simoninns/Acorn-Master-AIV/(threads)

Thread 1 (2019-06-06):

Sheet 17 - RTC IC identification number incorrect

simoninns, 2019-06-06:
The original Master 128 schematic only says 146818 and the chip datasheet for the MC146818P states that 1 and 16 are NC. So I'd conclude that both the new schematic and the original are incorrect, as the chip has to be a 'P' since the 'A' datasheet shows 1 and 16 to have a function.

i.e. the schematic should be marked MC146818P not MC146818A

kgl2001, 2019-06-06:
The MC146818 and MC146818P are one of the same thing. The P suffix just defines the Plastic package case.

The MC146818A on the other hand is something subtly different. It is an upgraded version of the MC146818 which utilises pins 1 & 16 for other functions. The MC146818A also comes in various packages, including P and this is sometimes referred to as MC146818AP.

I believe your final conclusion is correct. The schematic should be marked either MC146818 or MC146818P. It should not be MC146818A.

simoninns, 2019-06-06:
Fixed in latest commit

Closed 2019-06-06.

Thread 3 (2020-04-16):

16MHz Clock routing error

kgl2001, 2020-04-16:
As per post on Stardot:

https://stardot.org.uk/forums/viewtopic.php?f=3&t=16827&p=265560#p265560

In the schematic you have 16MHz clock from IC43 pin 2 wired directly to IC40 pin 9 & IC42 pin 8 and indirectly to IC35 pin 2 via the jumper LK60.

According to the circuit diagram on MDFS, the 16MHz clock from IC43 pin 2 should be wired direct to IC40 pin 9, and indirectly to IC42 pin 8 & IC35 pin 2 via the jumper LK60.

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
