simoninns/Acorn-Master-AIV/Schematics/Acorn 65C102 Second Processor/PDF/Acorn 65C102 Second Processor.pdf

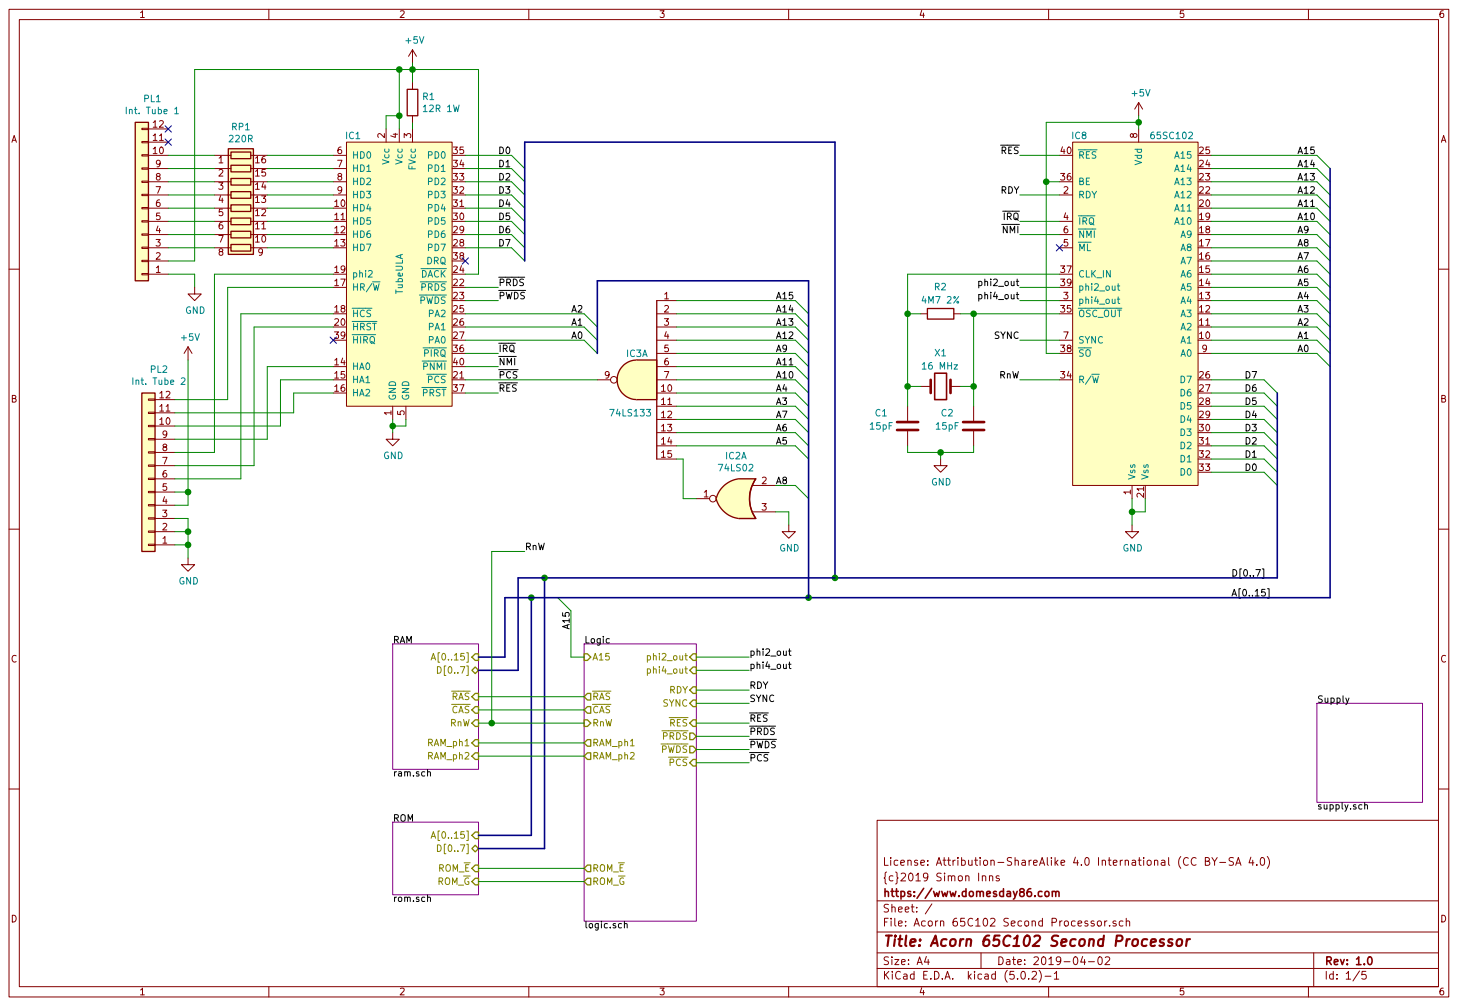
[picture p1: page 1]

+5V GND 1 1223456789 PL2 10

{c}2019 Simon Inns
Id: 1/5 Title: Acorn 65C102 Second Processor File: Acorn 65C102 Second Processor.sch Sheet: / https://www.domesday86.com

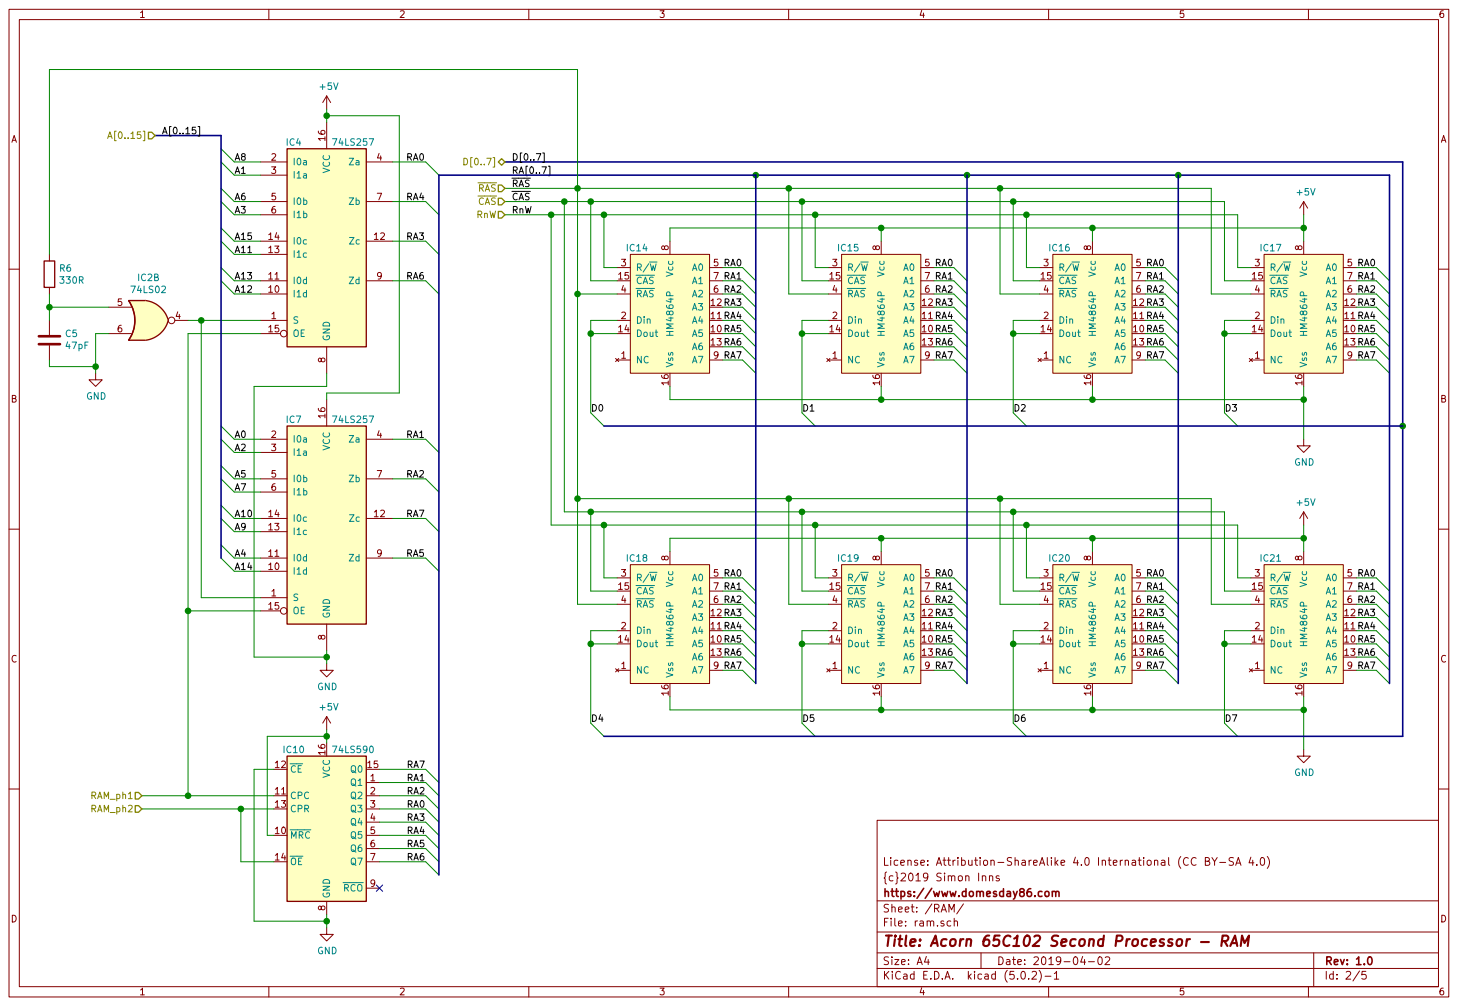
[picture p2: page 2]

RA[0..7] RAS CAS RnW S 1

License: Attribution-ShareAlike 4.0 International (CC BY-SA 4.0)
{c}2019 Simon Inns
File: ram.sch Sheet: /RAM/ https://www.domesday86.com

Id: 2/5 Title: Acorn 65C102 Second Processor - RAM

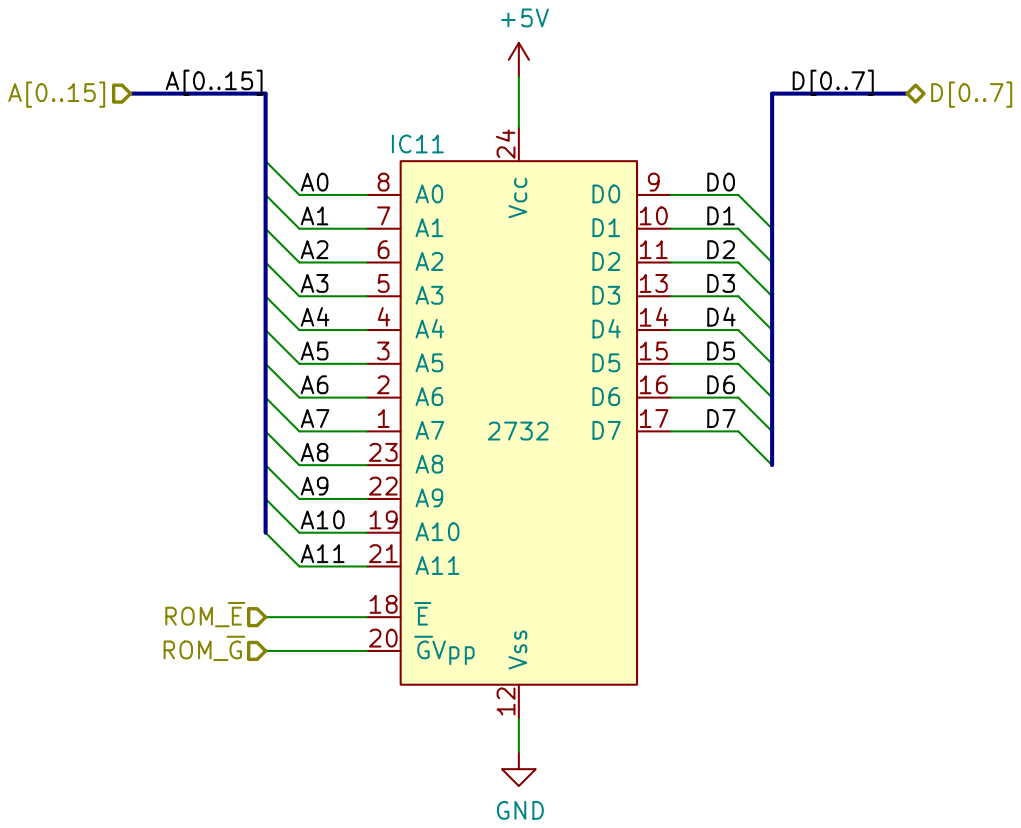
[picture p3: page 3]

{c}2019 Simon Inns
File: rom.sch Sheet: /ROM/ https://www.domesday86.com

Id: 3/5 Title: Acorn 65C102 Second Processor - ROM

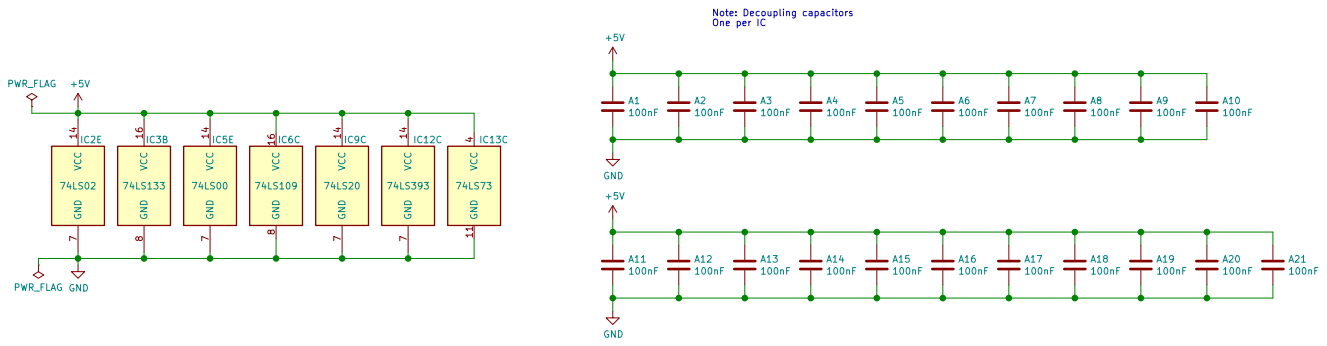
[picture p4: page 4]

License: Attribution-ShareAlike 4.0 International (CC BY-SA 4.0) VCC 14 GND

{c}2019 Simon Inns
https://www.domesday86.com
Sheet: /Supply/
File: supply.sch
Id: 4/5 Title: Acorn 65C102 Second Processor - Supply

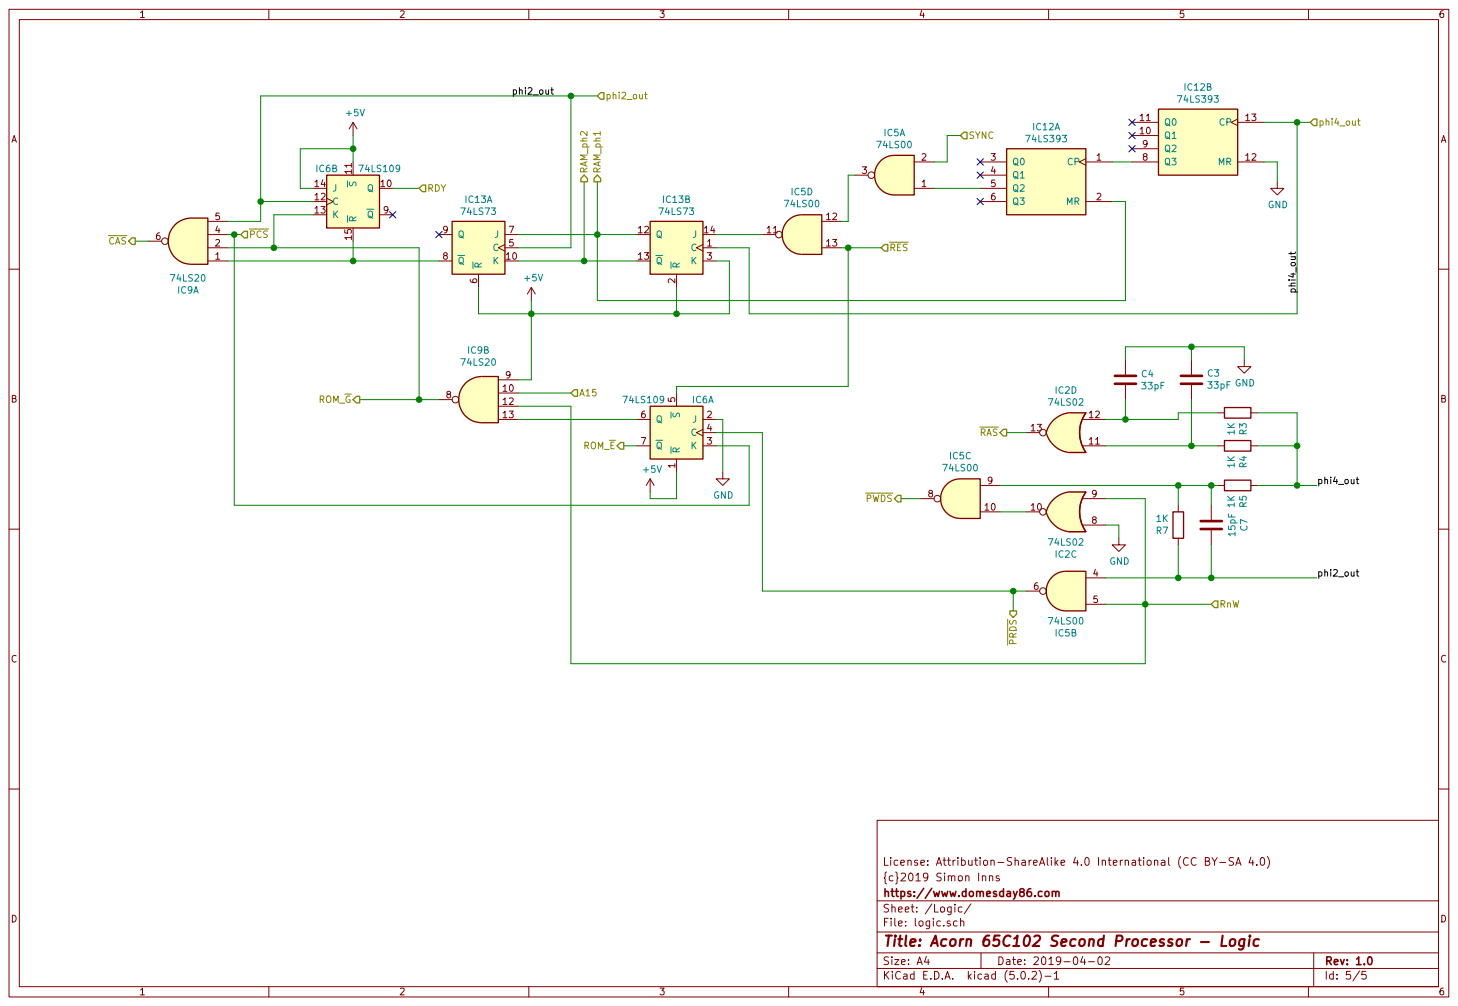
[picture p5: page 5]

License: Attribution-ShareAlike 4.0 International (CC BY-SA 4.0)
{c}2019 Simon Inns
https://www.domesday86.com
Sheet: /Logic/
File: logic.sch
Id: 5/5 Title: Acorn 65C102 Second Processor - Logic
