simoninns/Acorn-Master-AIV/Schematics/Acorn Master 128/Acorn Master 128/PDF/Acorn Master 128.pdf

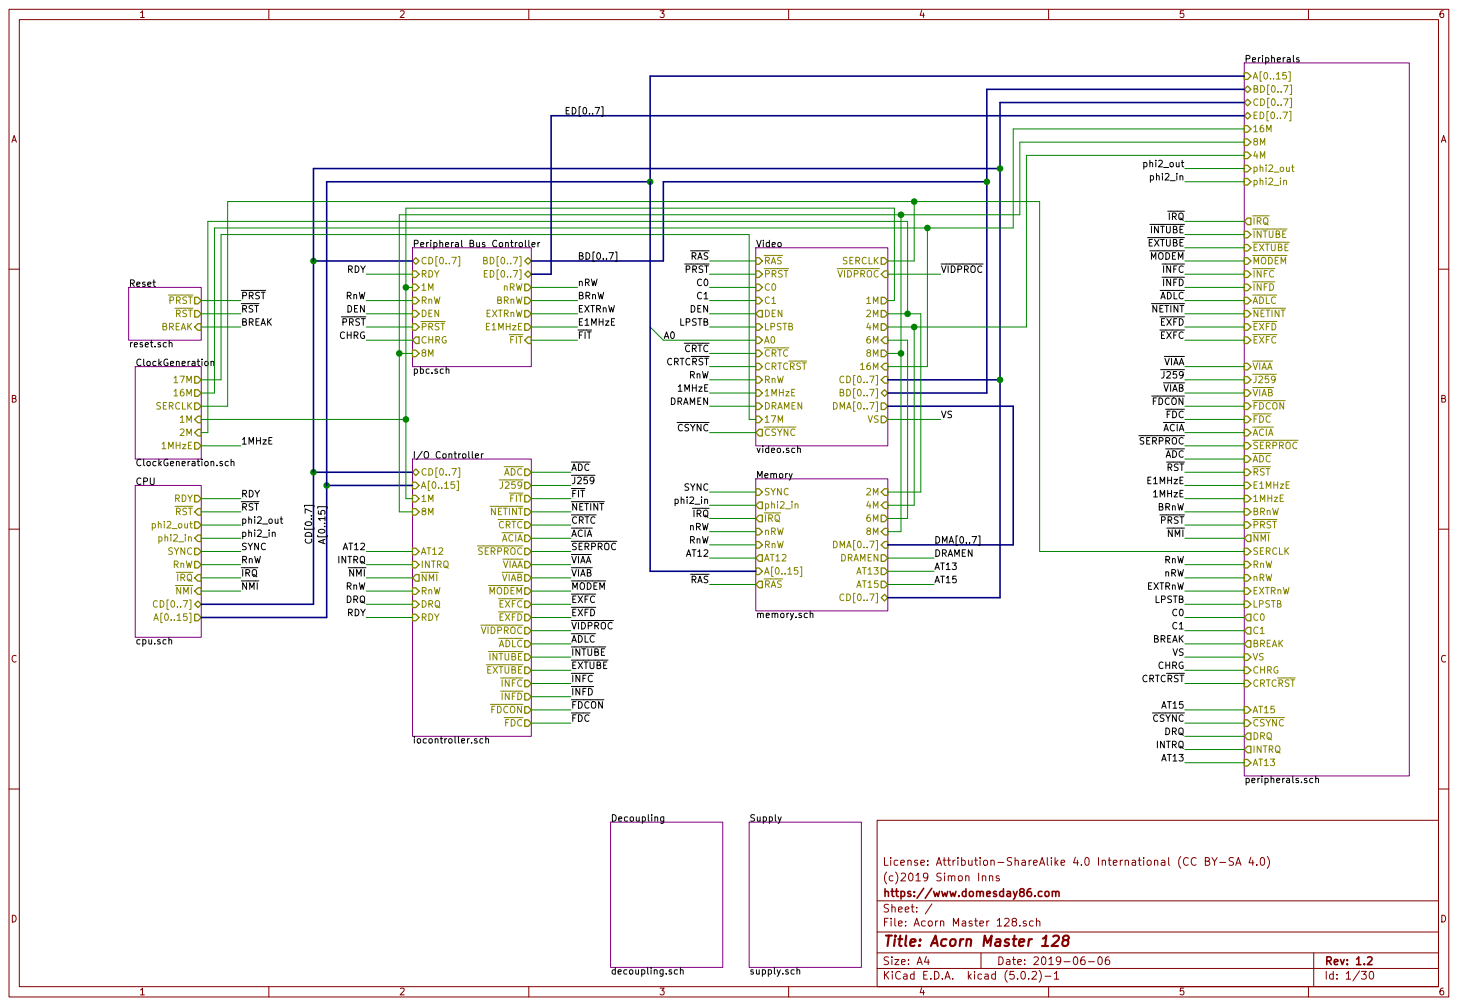
[picture p6: page 1]

A0 Reset reset.sch PRST RST BREAK

BD[0..7] ClockGeneration ClockGeneration.sch SERCLK

License: Attribution-ShareAlike 4.0 International (CC BY-SA 4.0) CPU

(c)2019 Simon Inns
File: Acorn Master 128.sch Sheet: / https://www.domesday86.com

Id: 1/30 Title: Acorn Master 128

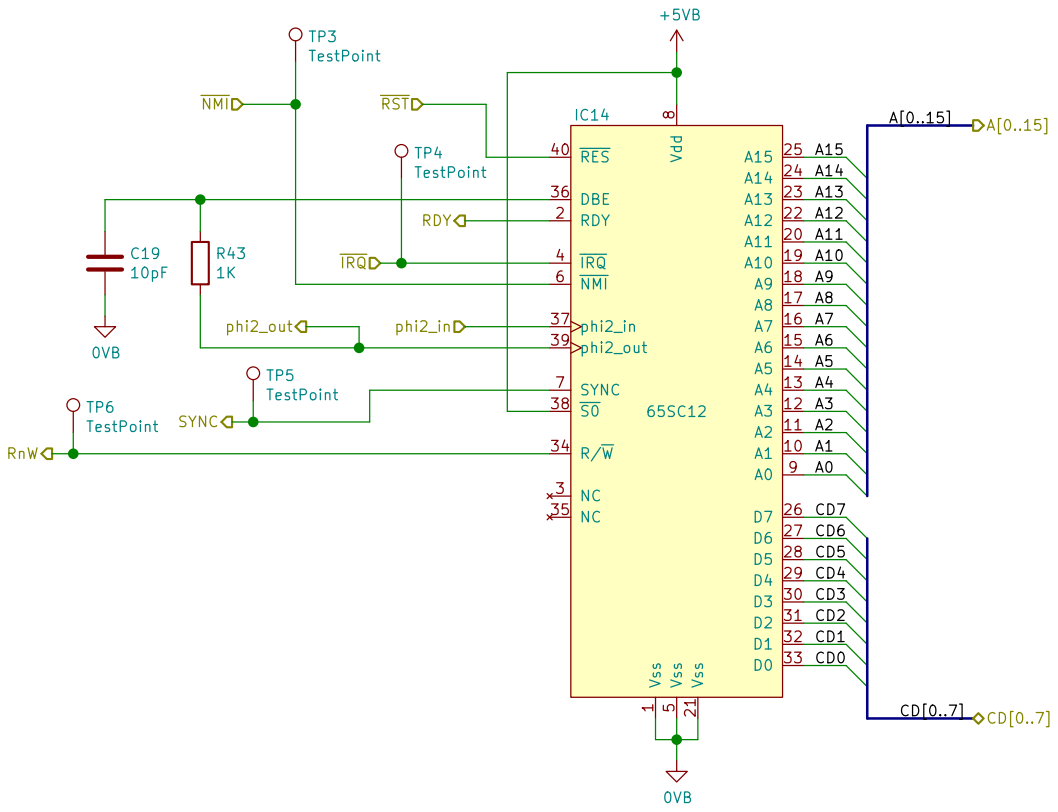
[picture p7: page 2]

(c)2019 Simon Inns
File: cpu.sch Sheet: /CPU/ https://www.domesday86.com

Id: 2/30 Title: Acorn Master 128 - CPU

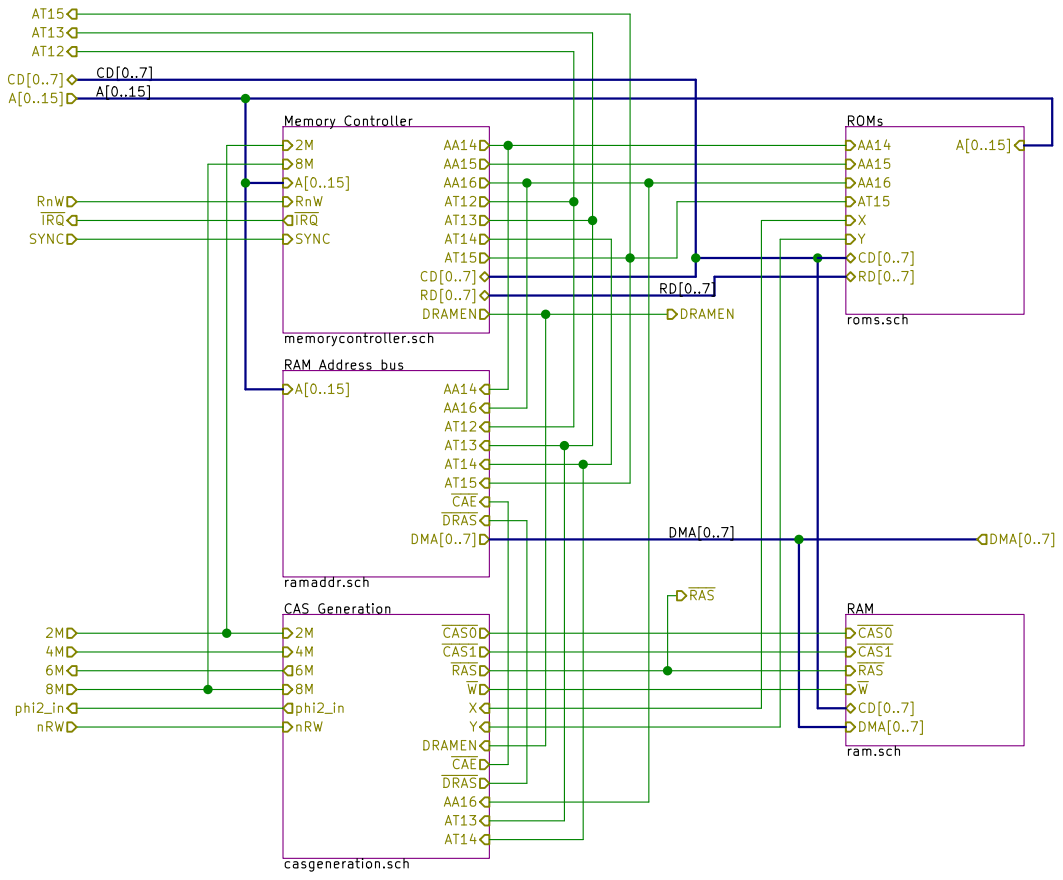
[picture p8: page 3]

memorycontroller.sch
DMA[0..7] RAM Address bus

ram.sch CAS0 RAS CAS1 CD[0..7] W

License: Attribution-ShareAlike 4.0 International (CC BY-SA 4.0)
(c)2019 Simon Inns
https://www.domesday86.com
Sheet: /Memory/
File: memory.sch
Id: 3/30 Title: Acorn Master 128 - Memory

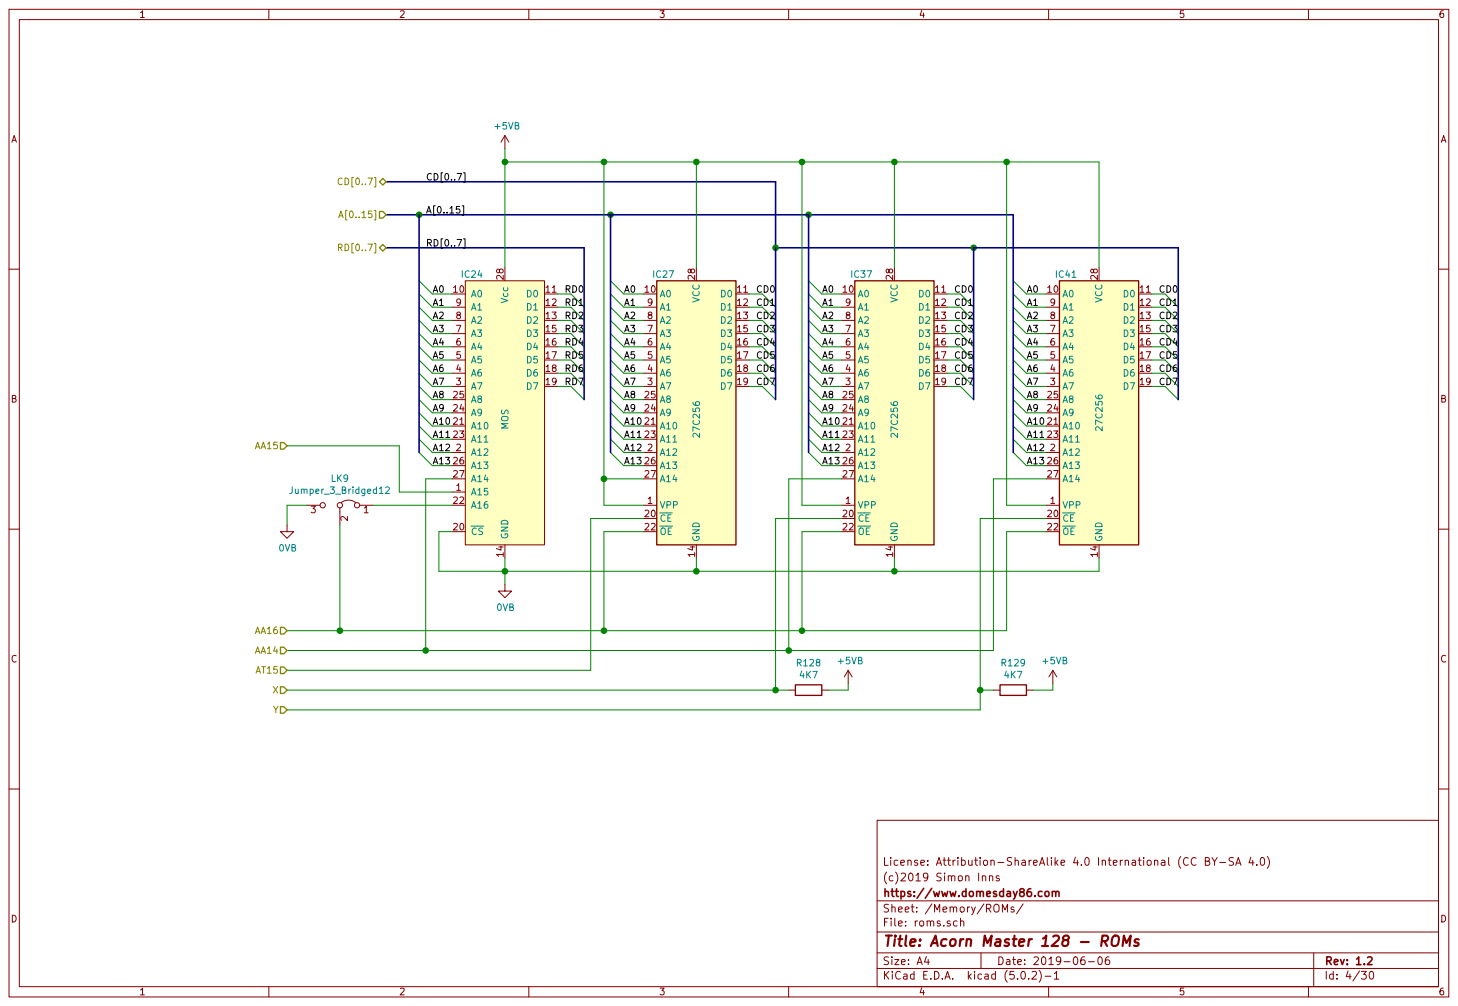
[picture p9: page 4]

(c)2019 Simon Inns
https://www.domesday86.com
File: roms.sch Sheet: /Memory/ROMs/
Id: 4/30 Title: Acorn Master 128 - ROMs

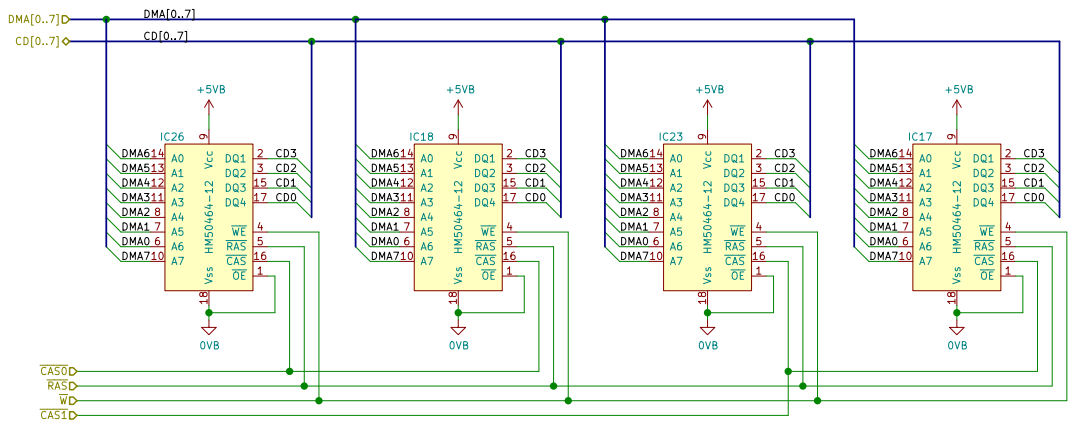
[picture p10: page 5]

(c)2019 Simon Inns
https://www.domesday86.com
File: ram.sch Sheet: /Memory/RAM/
Id: 5/30 Title: Acorn Master 128 - RAM

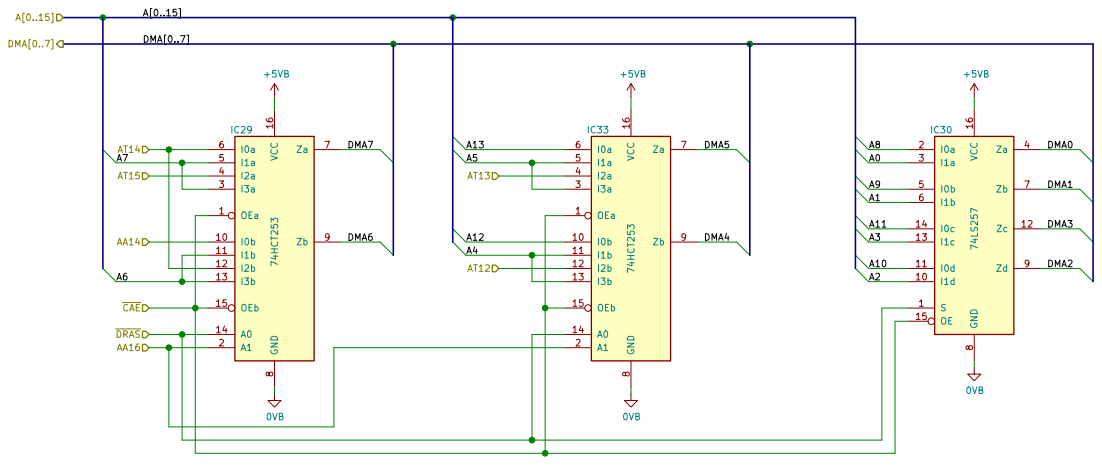
[picture p11: page 6]

License: Attribution-ShareAlike 4.0 International (CC BY-SA 4.0) OEa 1

I1b 11
I2b 12

(c)2019 Simon Inns
https://www.domesday86.com
File: ramaddr.sch Sheet: /Memory/RAM Address bus/
Id: 6/30 Title: Acorn Master 128 - RAM Address Bus

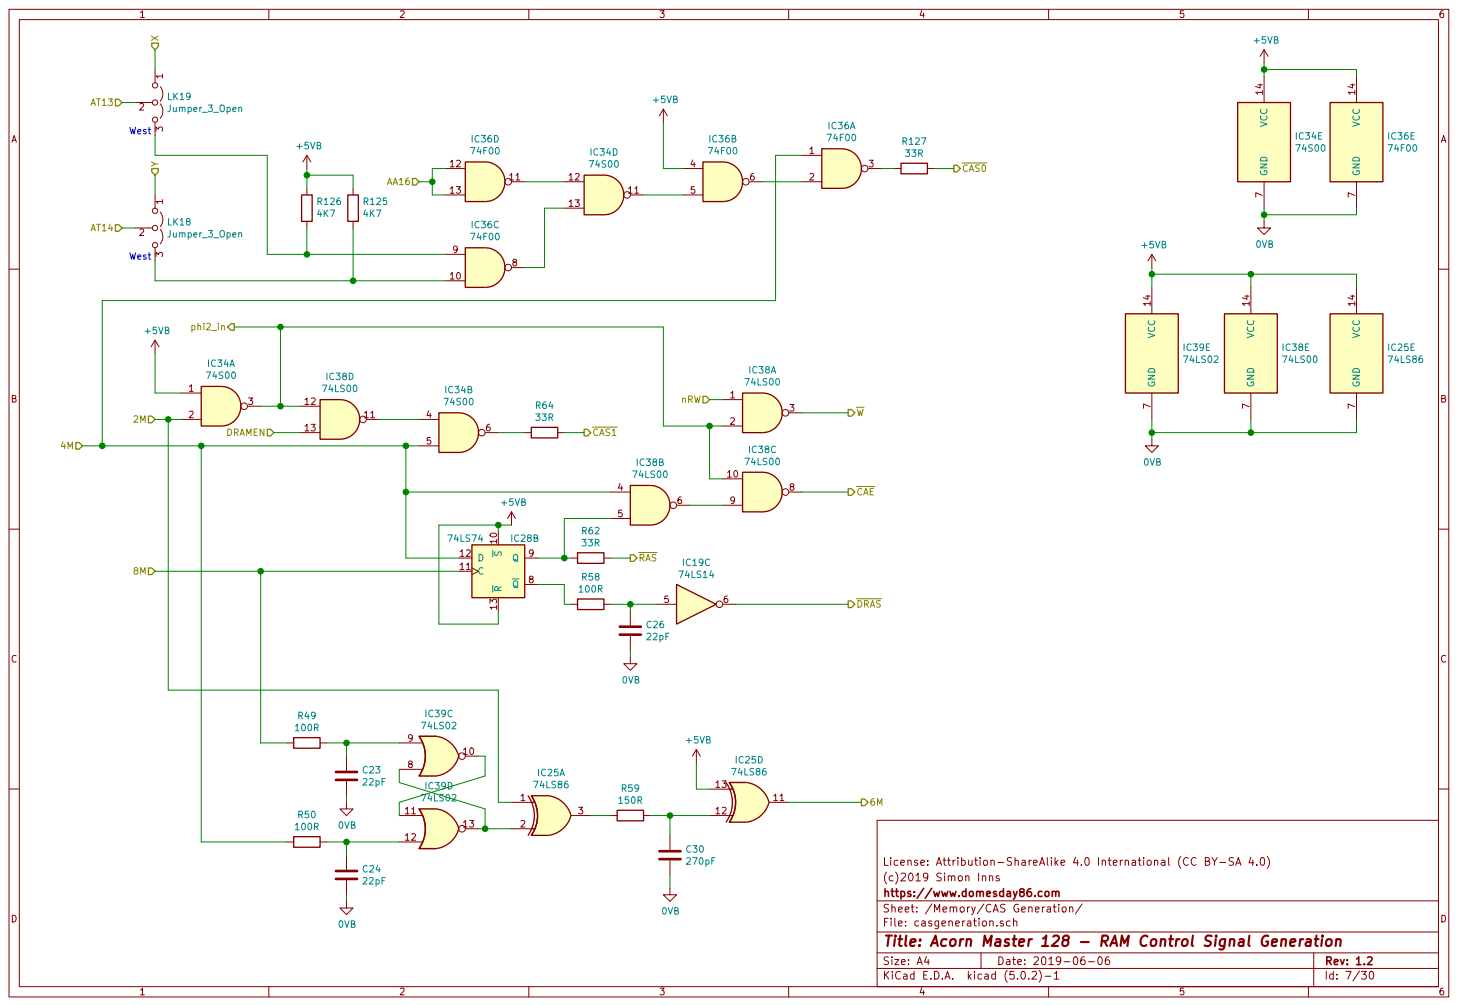
[picture p12: page 7]

License: Attribution-ShareAlike 4.0 International (CC BY-SA 4.0)
(c)2019 Simon Inns
https://www.domesday86.com
Sheet: /Memory/CAS Generation/
File: casgeneration.sch
Id: 7/30 Title: Acorn Master 128 - RAM Control Signal Generation

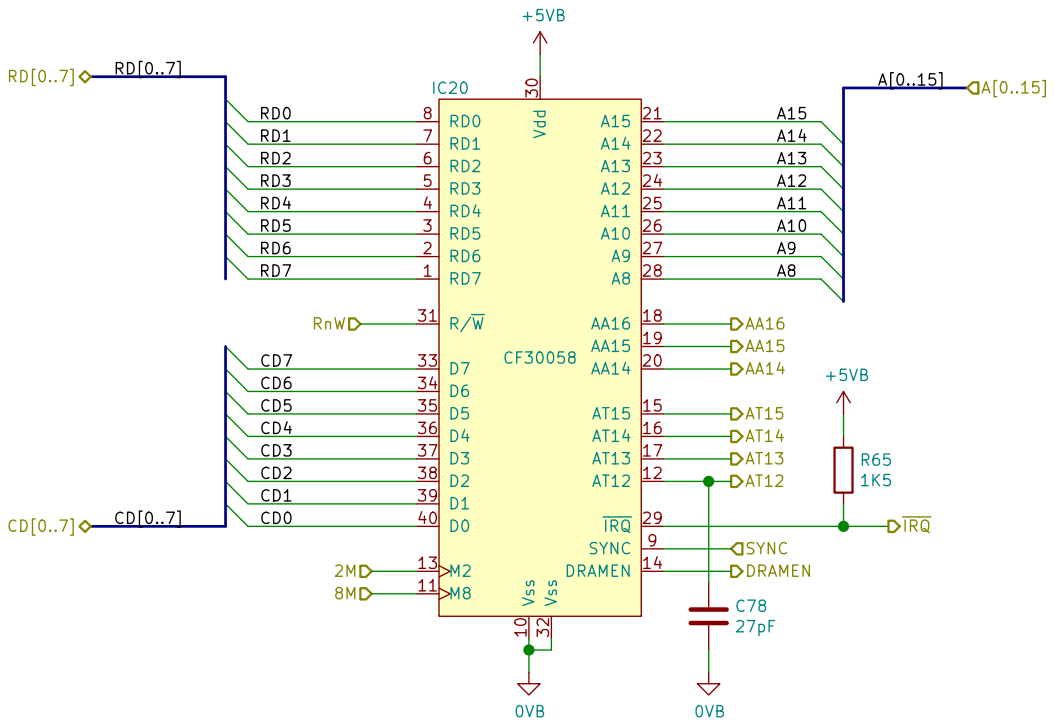
[picture p13: page 8]

(c)2019 Simon Inns
https://www.domesday86.com
Sheet: /Memory/Memory Controller/
File: memorycontroller.sch
Id: 8/30 Title: Acorn Master 128 - Memory Controller

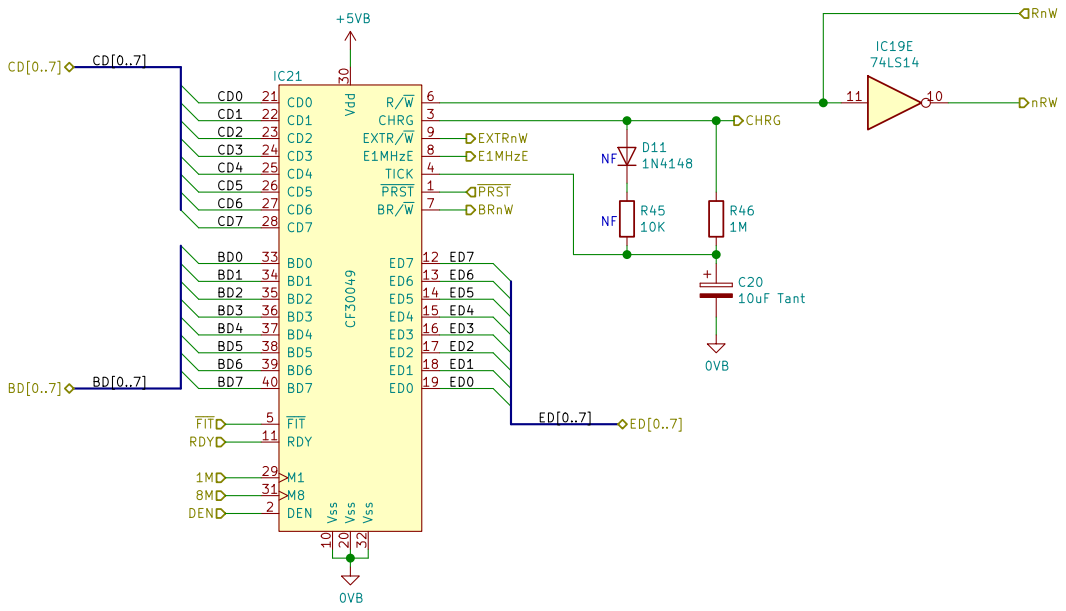
[picture p14: page 9]

License: Attribution-ShareAlike 4.0 International (CC BY-SA 4.0)
(c)2019 Simon Inns
https://www.domesday86.com
Sheet: /Peripheral Bus Controller/
File: pbc.sch
Id: 9/30 Title: Acorn Master 128 - Peripheral Bus Controller

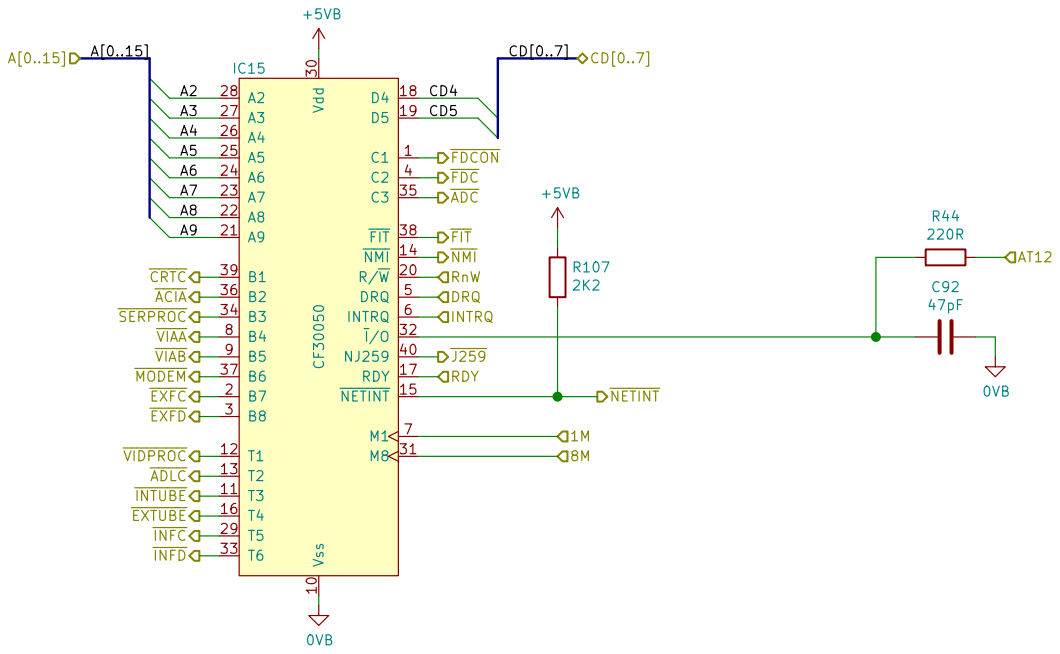
[picture p15: page 10]

License: Attribution-ShareAlike 4.0 International (CC BY-SA 4.0)
(c)2019 Simon Inns
Id: 10/30 Title: Acorn Master 128 - I/O Controller File: iocontroller.sch Sheet: /I/O Controller/ https://www.domesday86.com

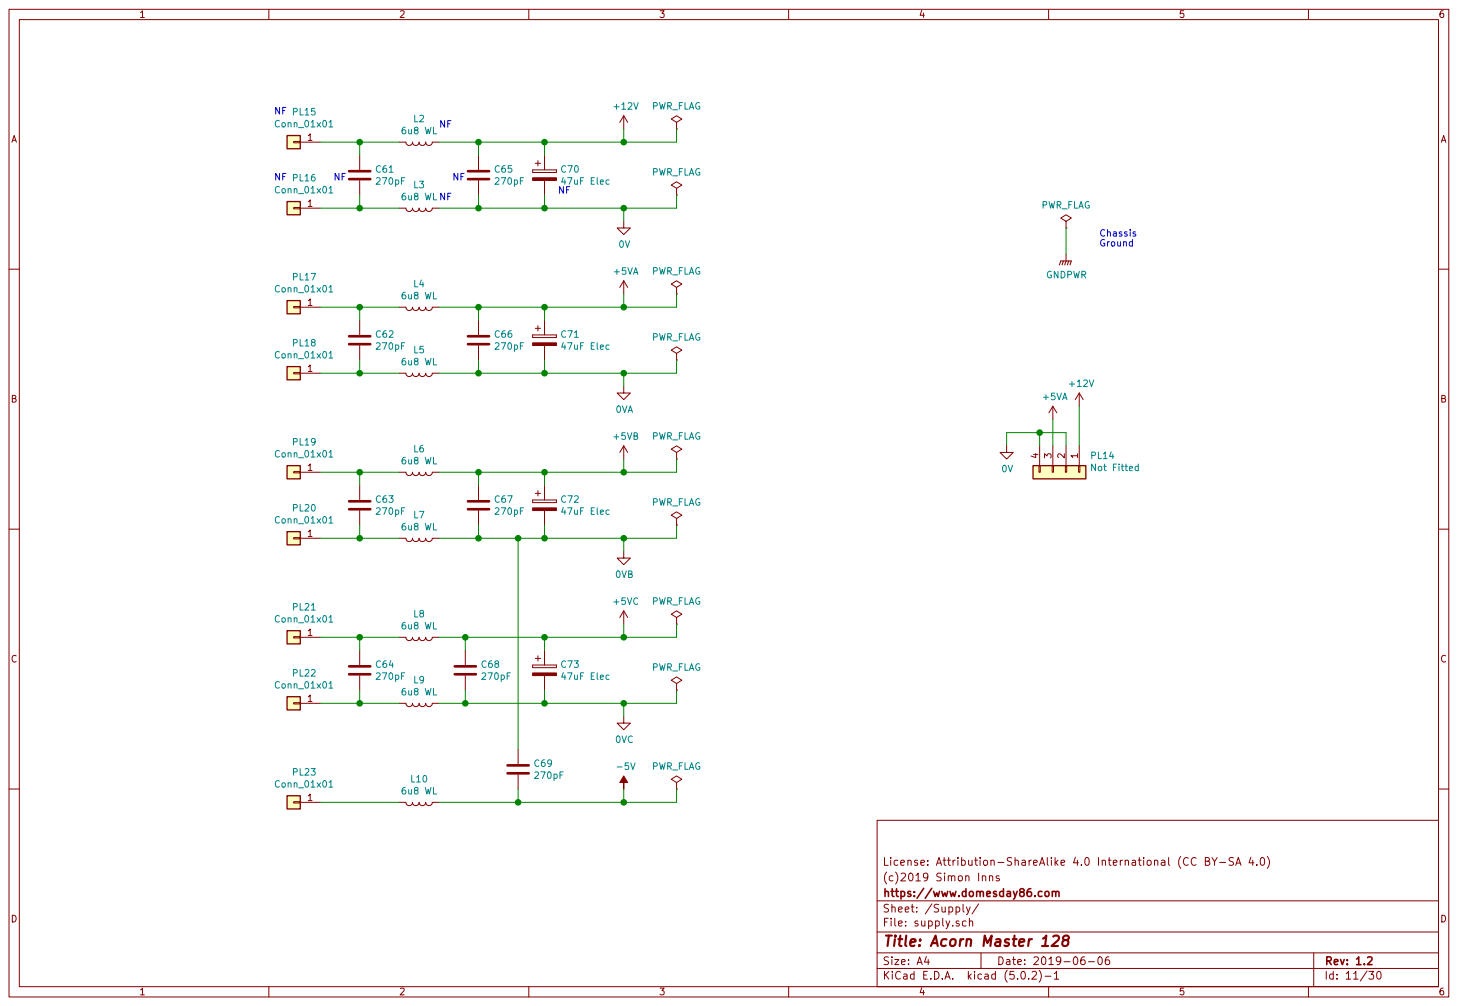
[picture p16: page 11]

License: Attribution-ShareAlike 4.0 International (CC BY-SA 4.0) 1 PL15 Conn_01x01 1 PL16 Conn_01x01 1 PL17 Conn_01x01 1 PL18 Conn_01x01 1 PL19 Conn_01x01 1 PL20 Conn_01x01 1 PL21 Conn_01x01 1 PL22 Conn_01x01 1 PL23 Conn_01x01

(c)2019 Simon Inns
https://www.domesday86.com
Sheet: /Supply/
File: supply.sch
Id: 11/30 Title: Acorn Master 128

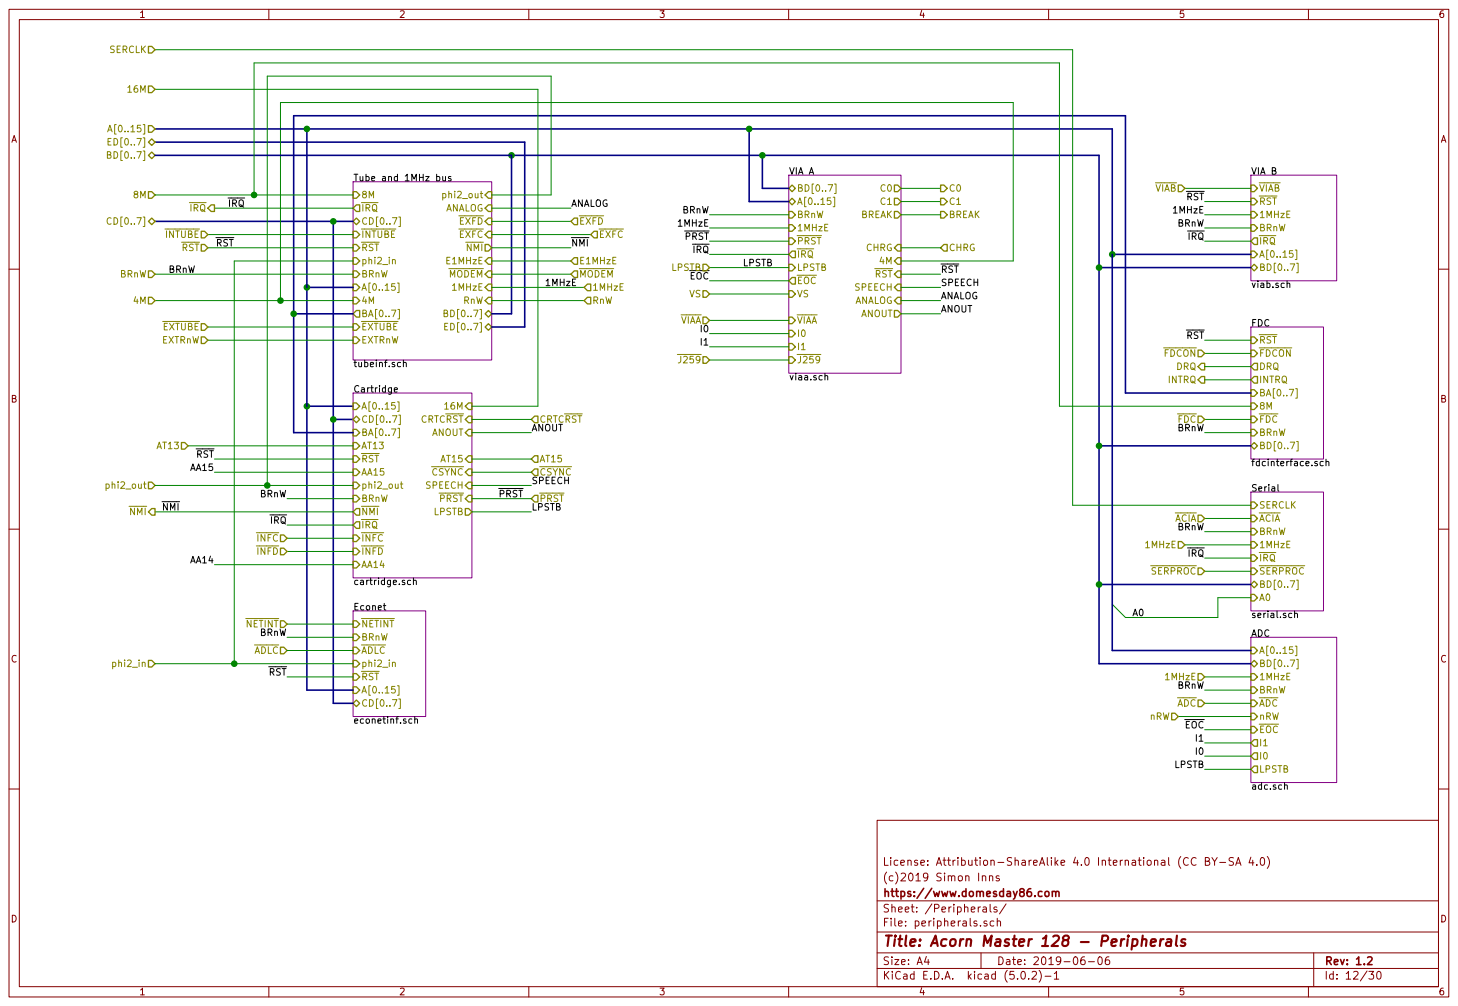
[picture p17: page 12]

VIA B
viab.sch VIAB RST

FDC
BRnW
Serial serial.sch SERCLK

License: Attribution-ShareAlike 4.0 International (CC BY-SA 4.0) Econet econetinf.sch NETINT BRnW

(c)2019 Simon Inns
https://www.domesday86.com
Sheet: /Peripherals/
File: peripherals.sch
Id: 12/30 Title: Acorn Master 128 - Peripherals

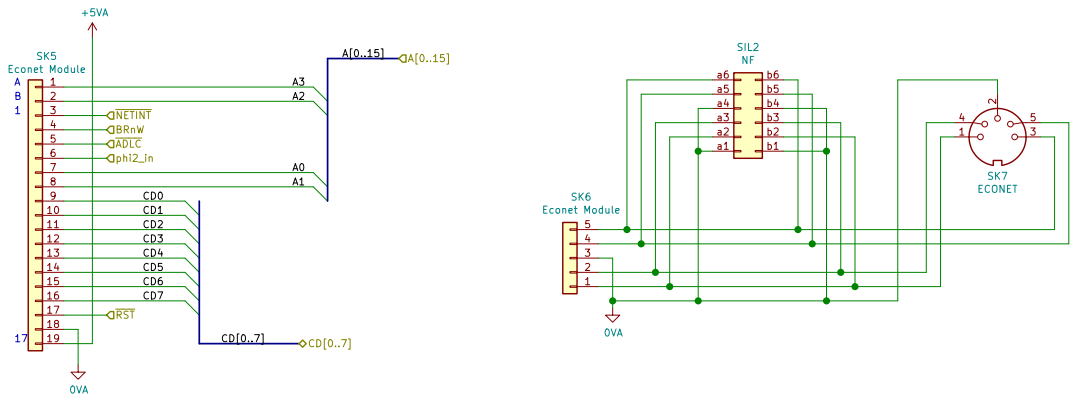
[picture p18: page 13]

a4 | | b4
a3 | | b3
a2 | | b2
a1 | | b1

License: Attribution-ShareAlike 4.0 International (CC BY-SA 4.0)
(c)2019 Simon Inns
https://www.domesday86.com
Id: 13/30 Title: Acorn Master 128 - Econet File: econetinf.sch Sheet: /Peripherals/Econet/

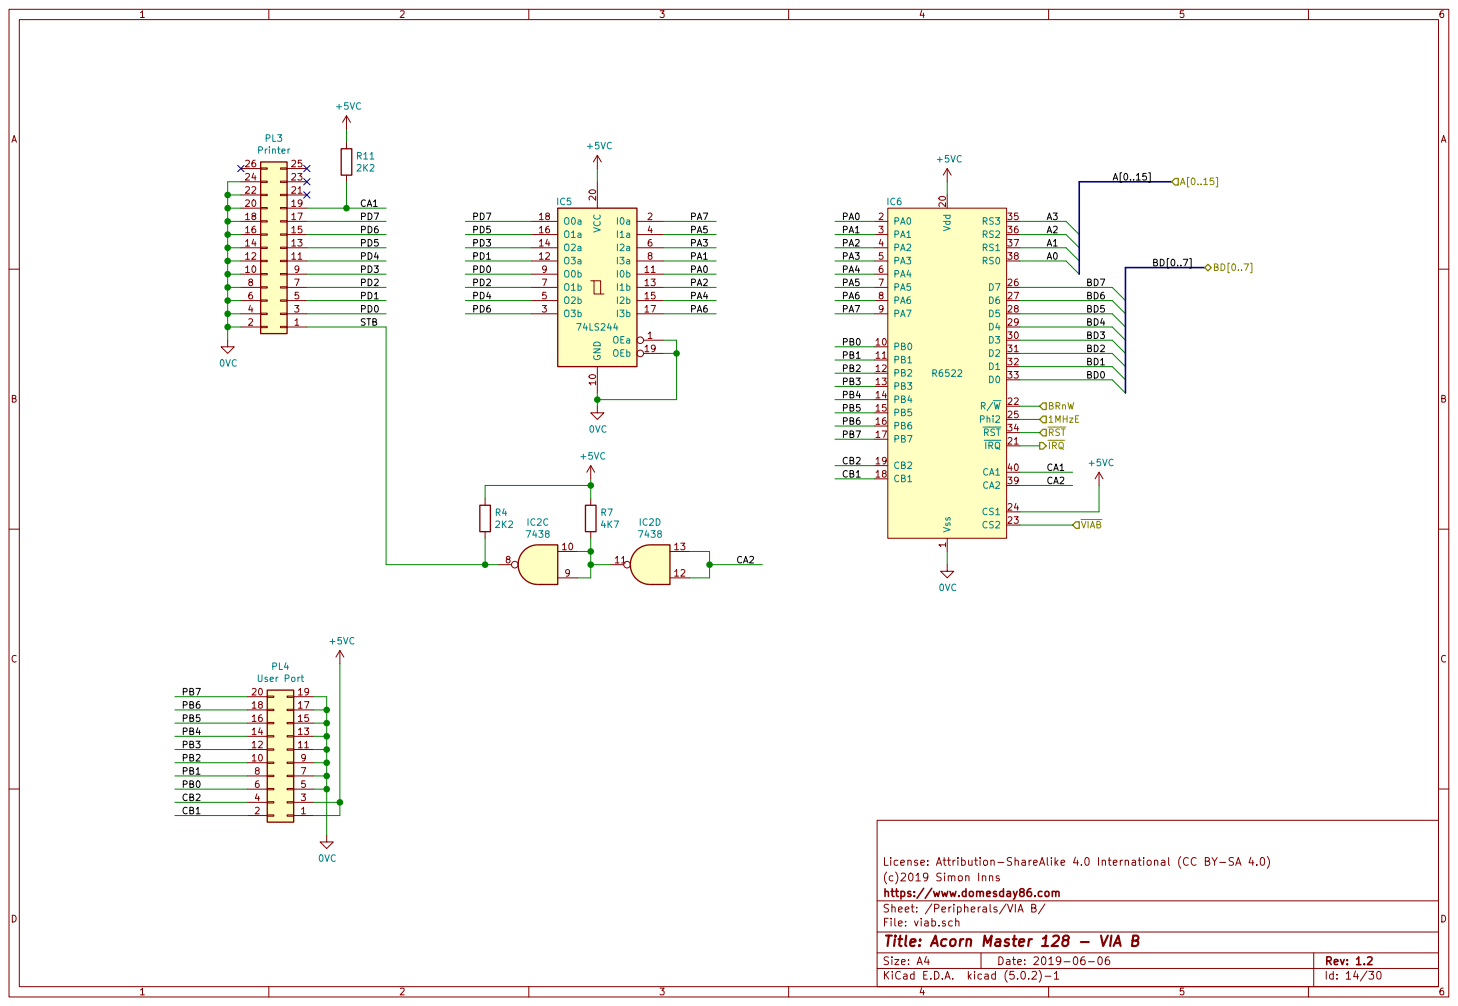
[picture p19: page 14]

16 | 15
14 | 13
12 | 11

License: Attribution-ShareAlike 4.0 International (CC BY-SA 4.0) 1

(c)2019 Simon Inns
https://www.domesday86.com
File: viab.sch Sheet: /Peripherals/VIA B/
Id: 14/30 Title: Acorn Master 128 - VIA B

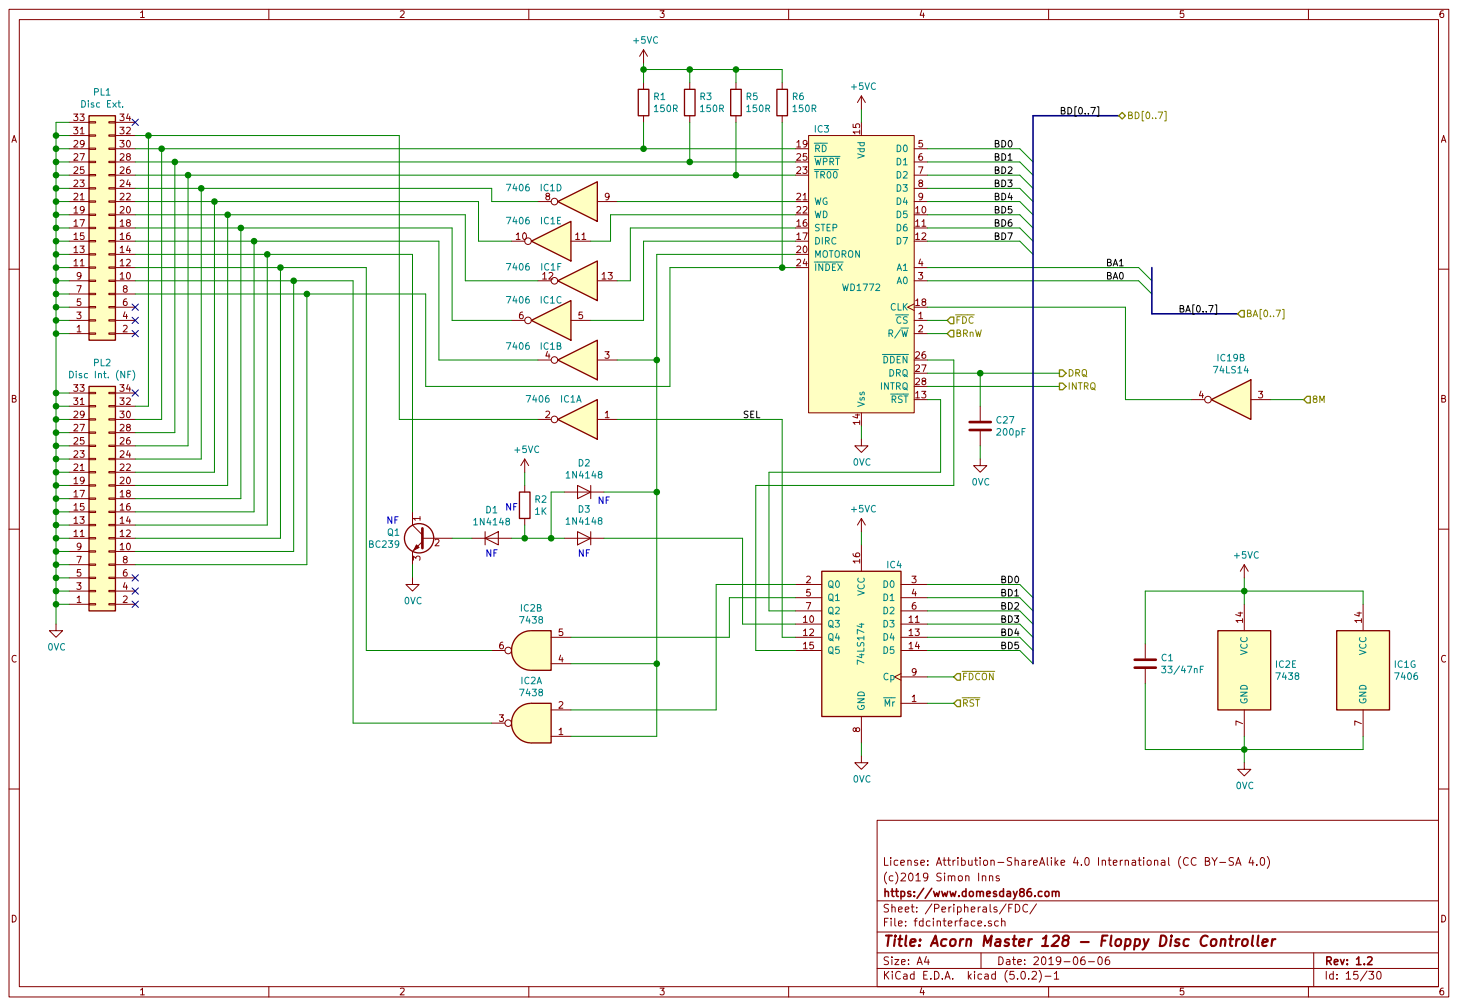
[picture p20: page 15]

293 21 | 22
27 | 28
25 | 26
23 | 24

15 | 16
13 | 14
11 | 12

License: Attribution-ShareAlike 4.0 International (CC BY-SA 4.0)
(c)2019 Simon Inns
https://www.domesday86.com
Id: 15/30 Title: Acorn Master 128 - Floppy Disc Controller File: fdcinterface.sch Sheet: /Peripherals/FDC/

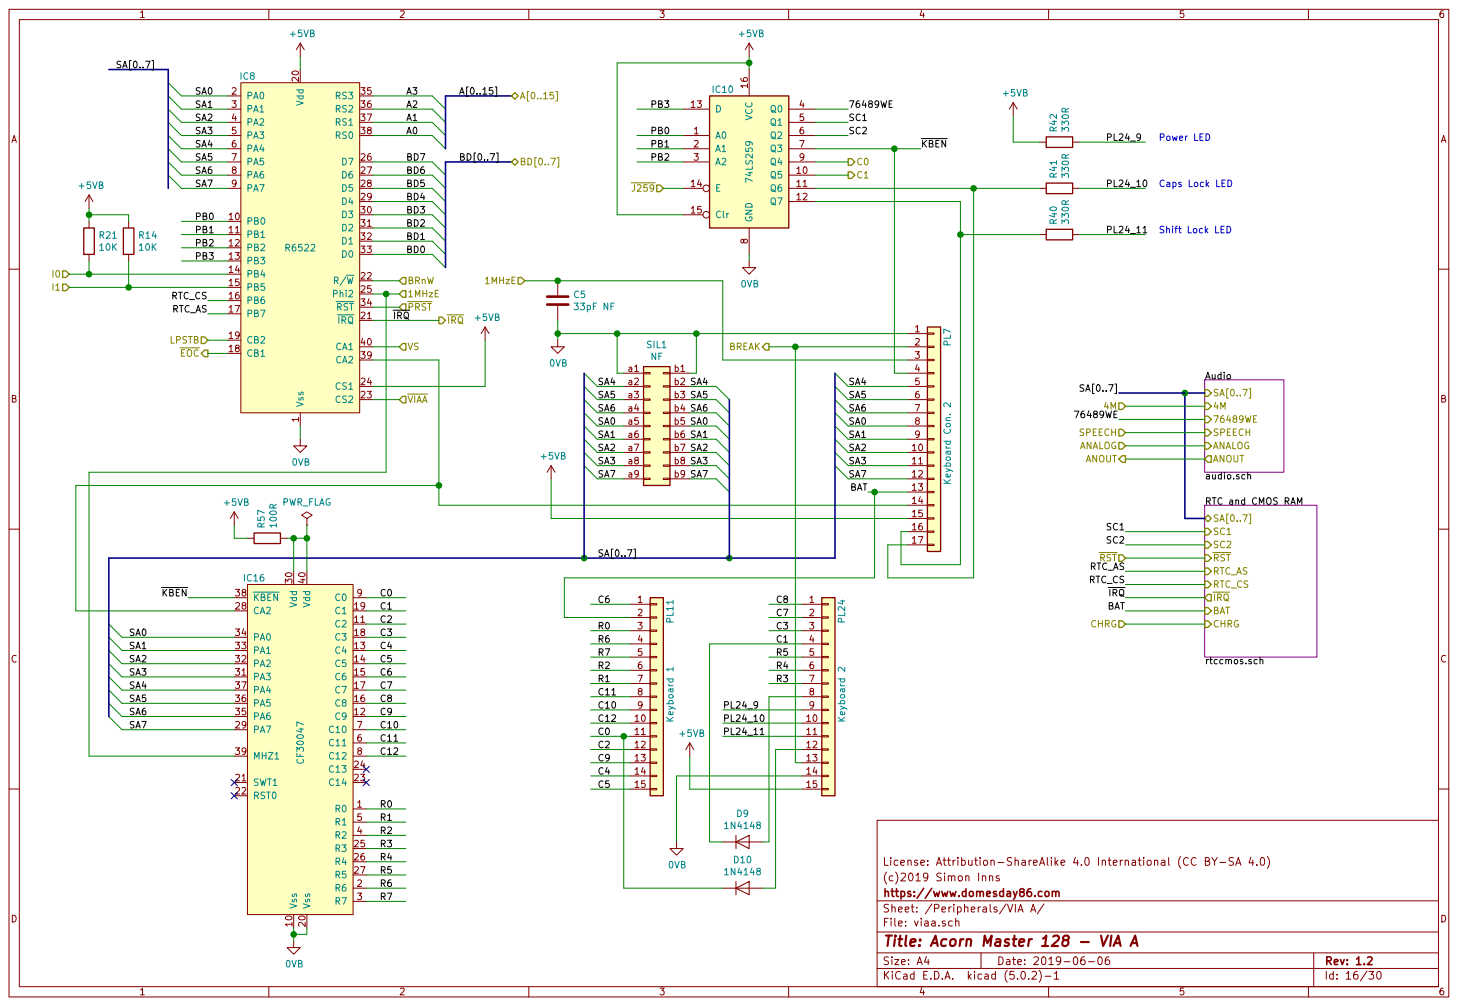
[picture p21: page 16]

10
11
12

(c)2019 Simon Inns
https://www.domesday86.com
File: viaa.sch Sheet: /Peripherals/VIA A/
Id: 16/30 Title: Acorn Master 128 - VIA A

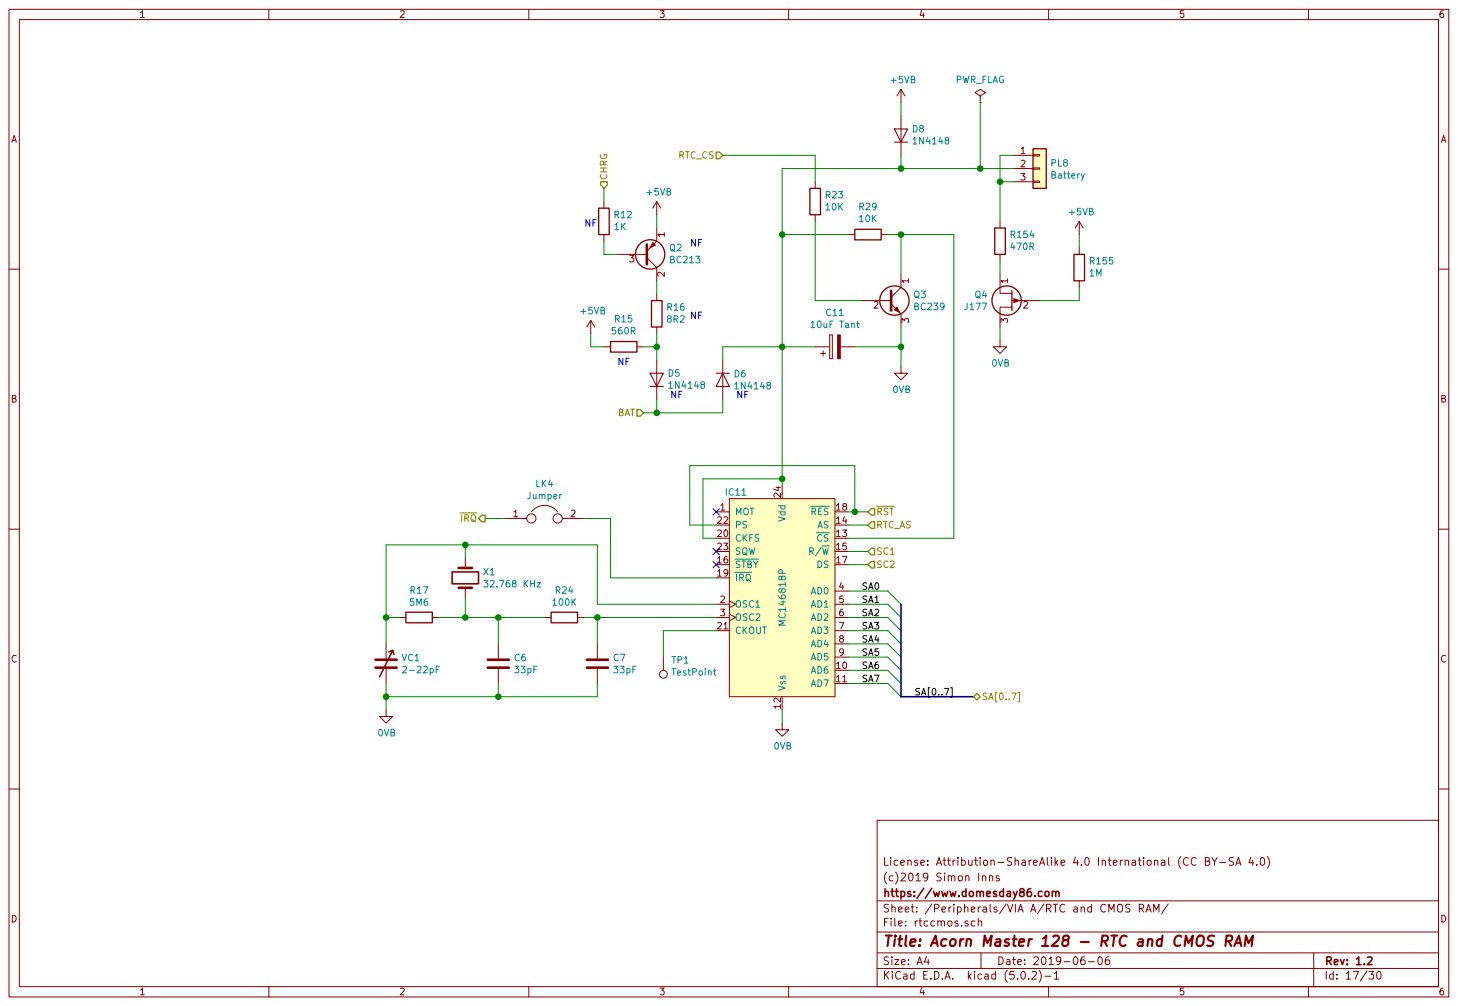
[picture p22: page 17]

(c)2019 Simon Inns
https://www.domesday86.com
File: rtccmos.sch Sheet: /Peripherals/VIA A/RTC and CMOS RAM/
Id: 17/30 Title: Acorn Master 128 - RTC and CMOS RAM

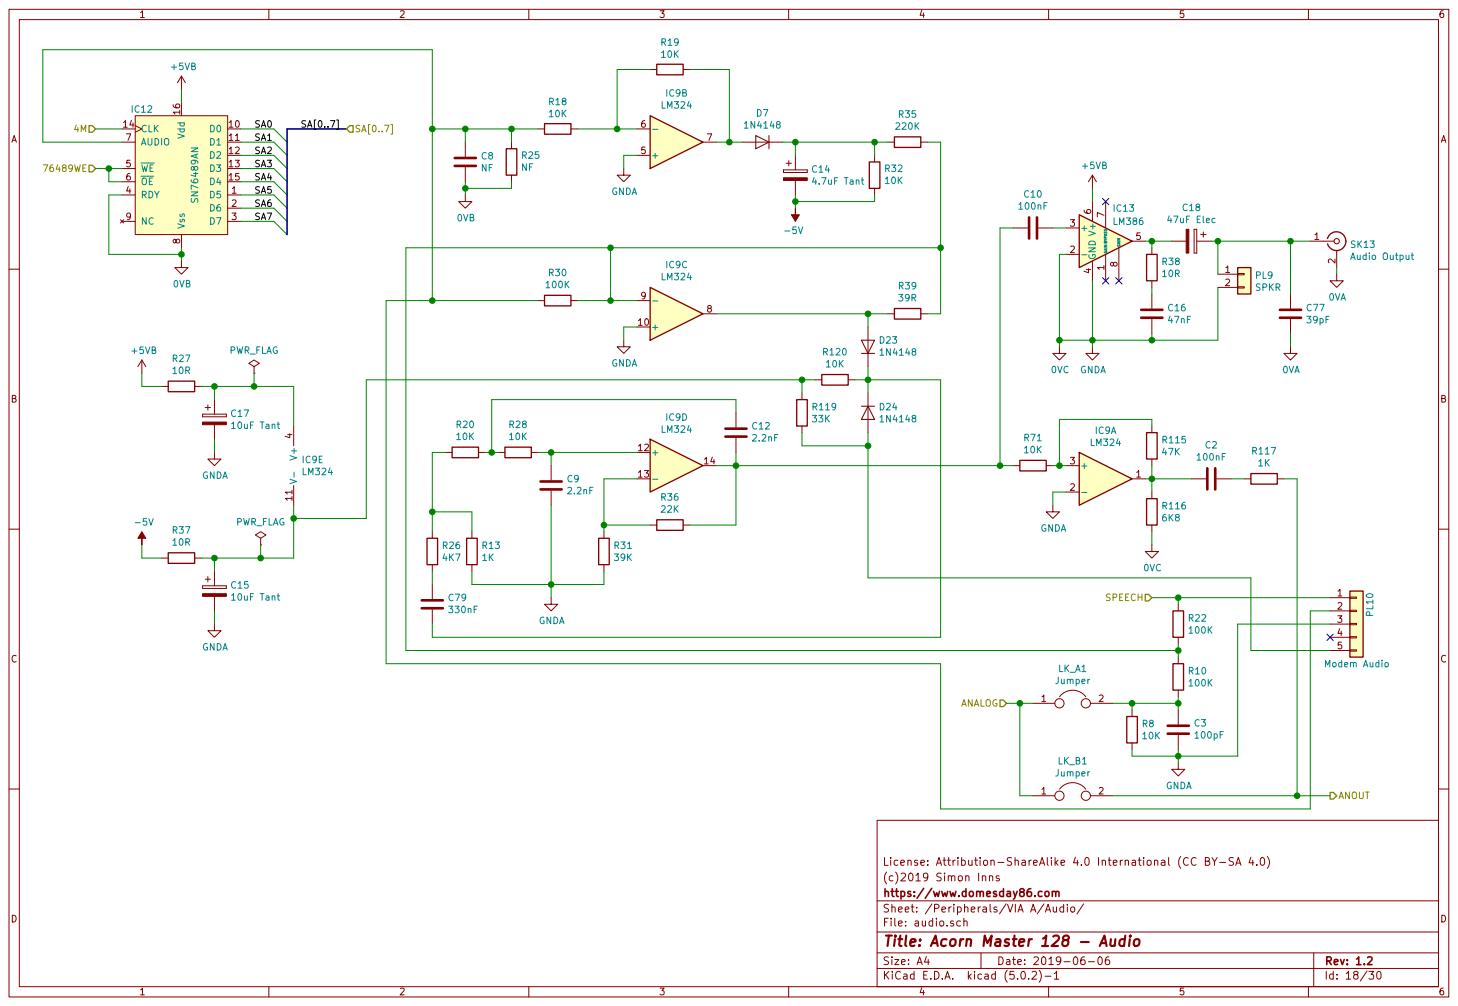
[picture p23: page 18]

License: Attribution-ShareAlike 4.0 International (CC BY-SA 4.0)
(c)2019 Simon Inns
https://www.domesday86.com
File: audio.sch Sheet: /Peripherals/VIA A/Audio/
Id: 18/30 Title: Acorn Master 128 - Audio

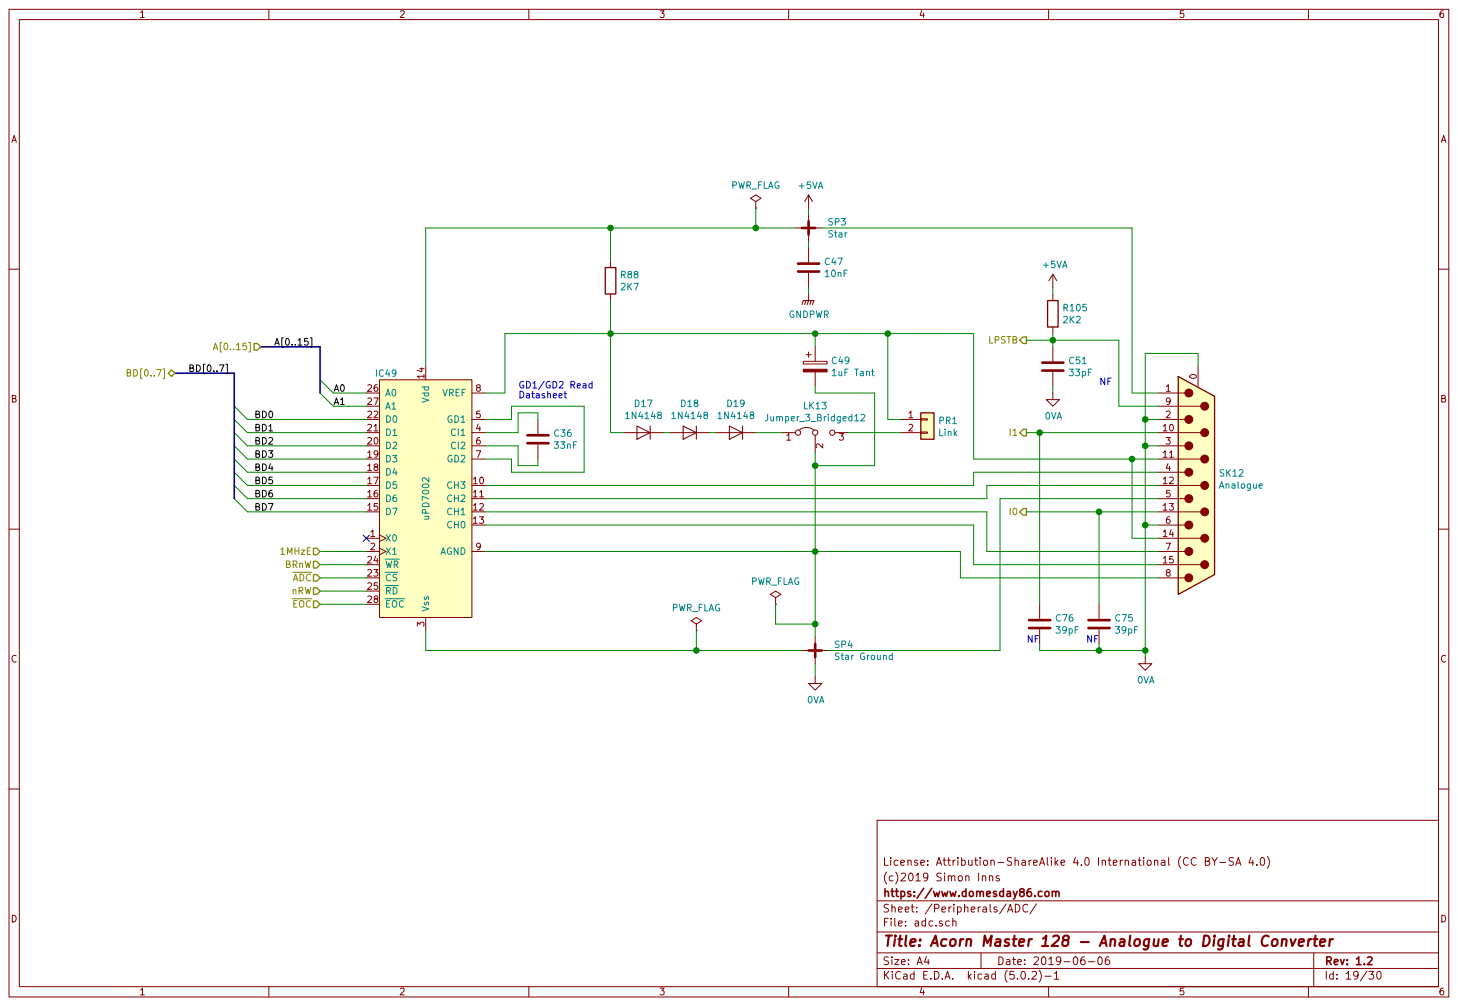
[picture p24: page 19]

(c)2019 Simon Inns
https://www.domesday86.com
Id: 19/30 Title: Acorn Master 128 - Analogue to Digital Converter File: adc.sch Sheet: /Peripherals/ADC/

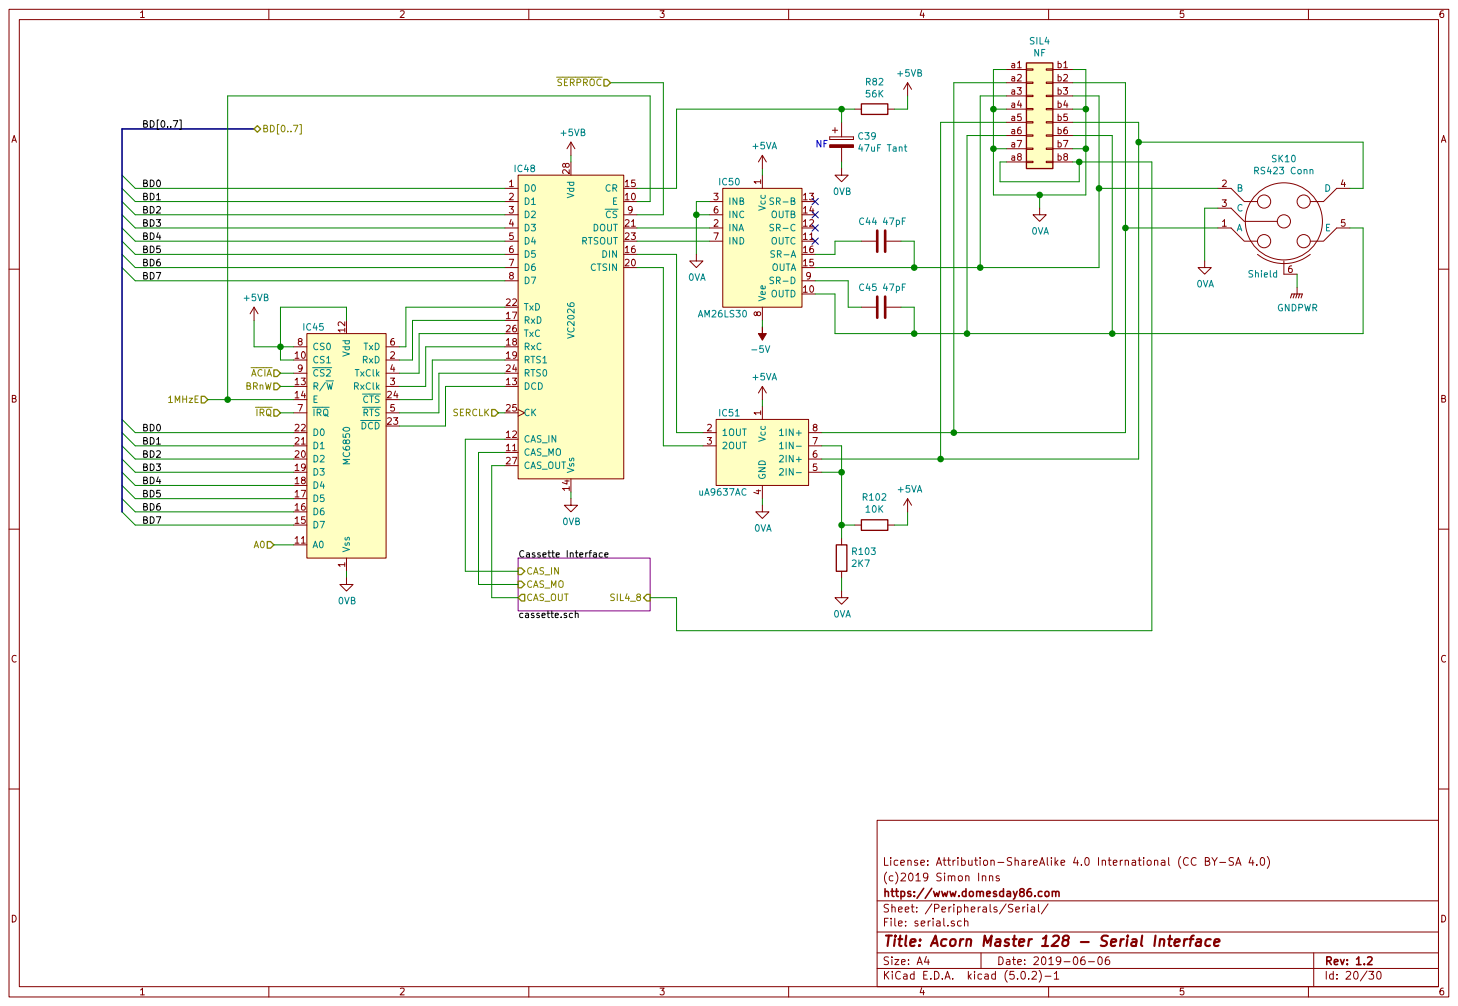
[picture p25: page 20]

a2 | | b8 SIL4 NF b2

a3 | | b3
a4 | | b4
a5 | | b5
a6 | | b6
a7 | | b7

(c)2019 Simon Inns
https://www.domesday86.com
File: serial.sch Sheet: /Peripherals/Serial/
Id: 20/30 Title: Acorn Master 128 - Serial Interface

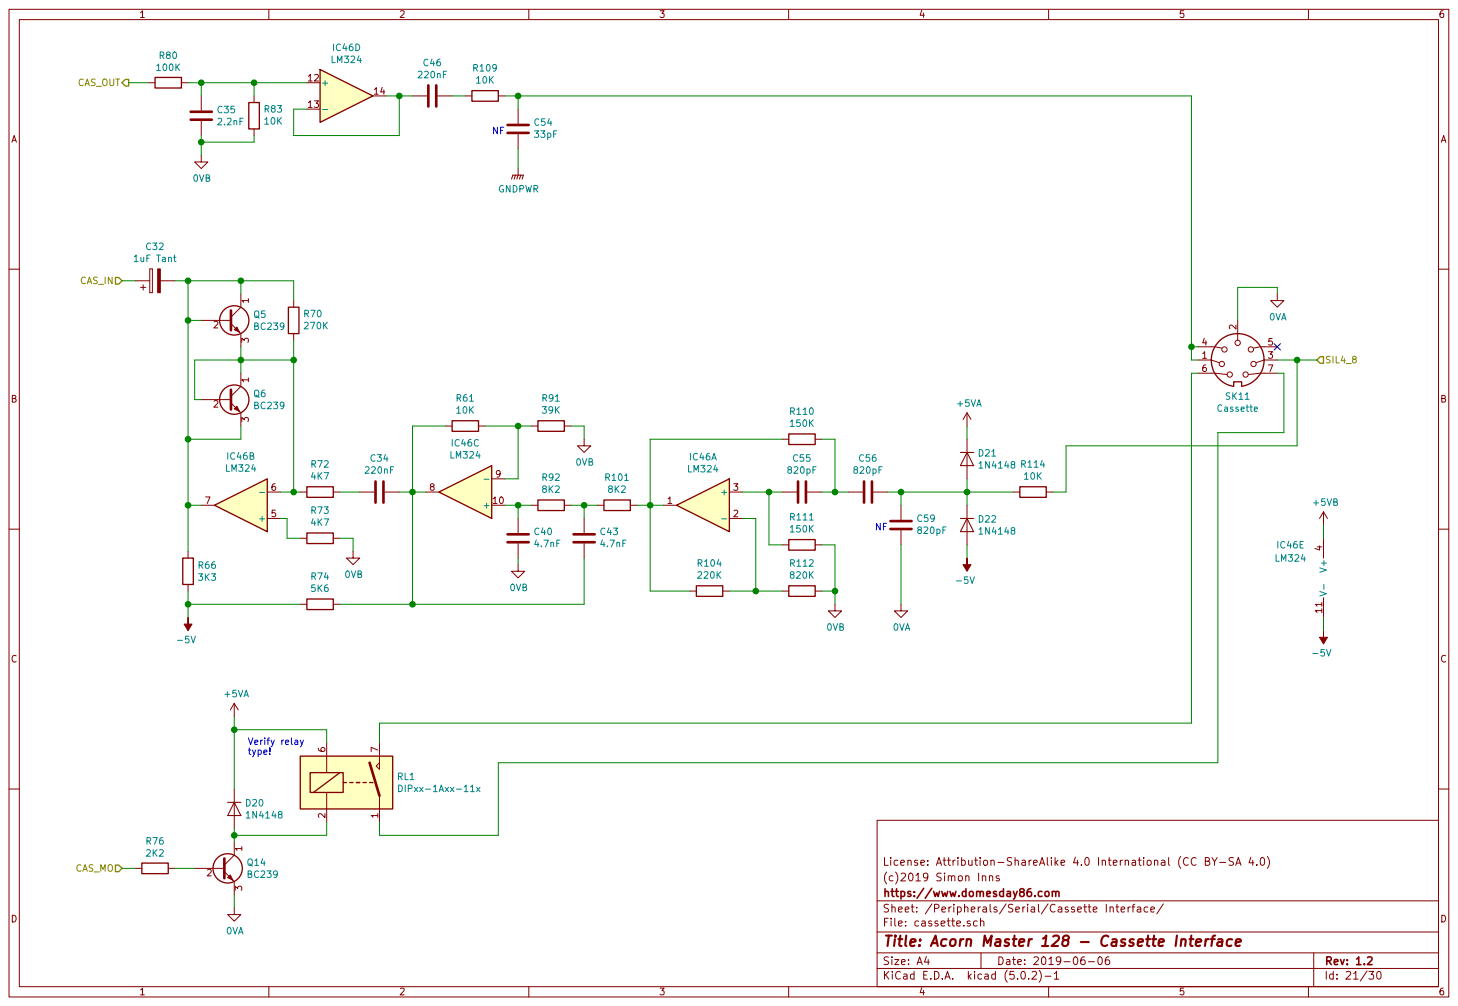
[picture p26: page 21]

License: Attribution-ShareAlike 4.0 International (CC BY-SA 4.0)
(c)2019 Simon Inns
https://www.domesday86.com
File: cassette.sch Sheet: /Peripherals/Serial/Cassette Interface/
Id: 21/30 Title: Acorn Master 128 - Cassette Interface

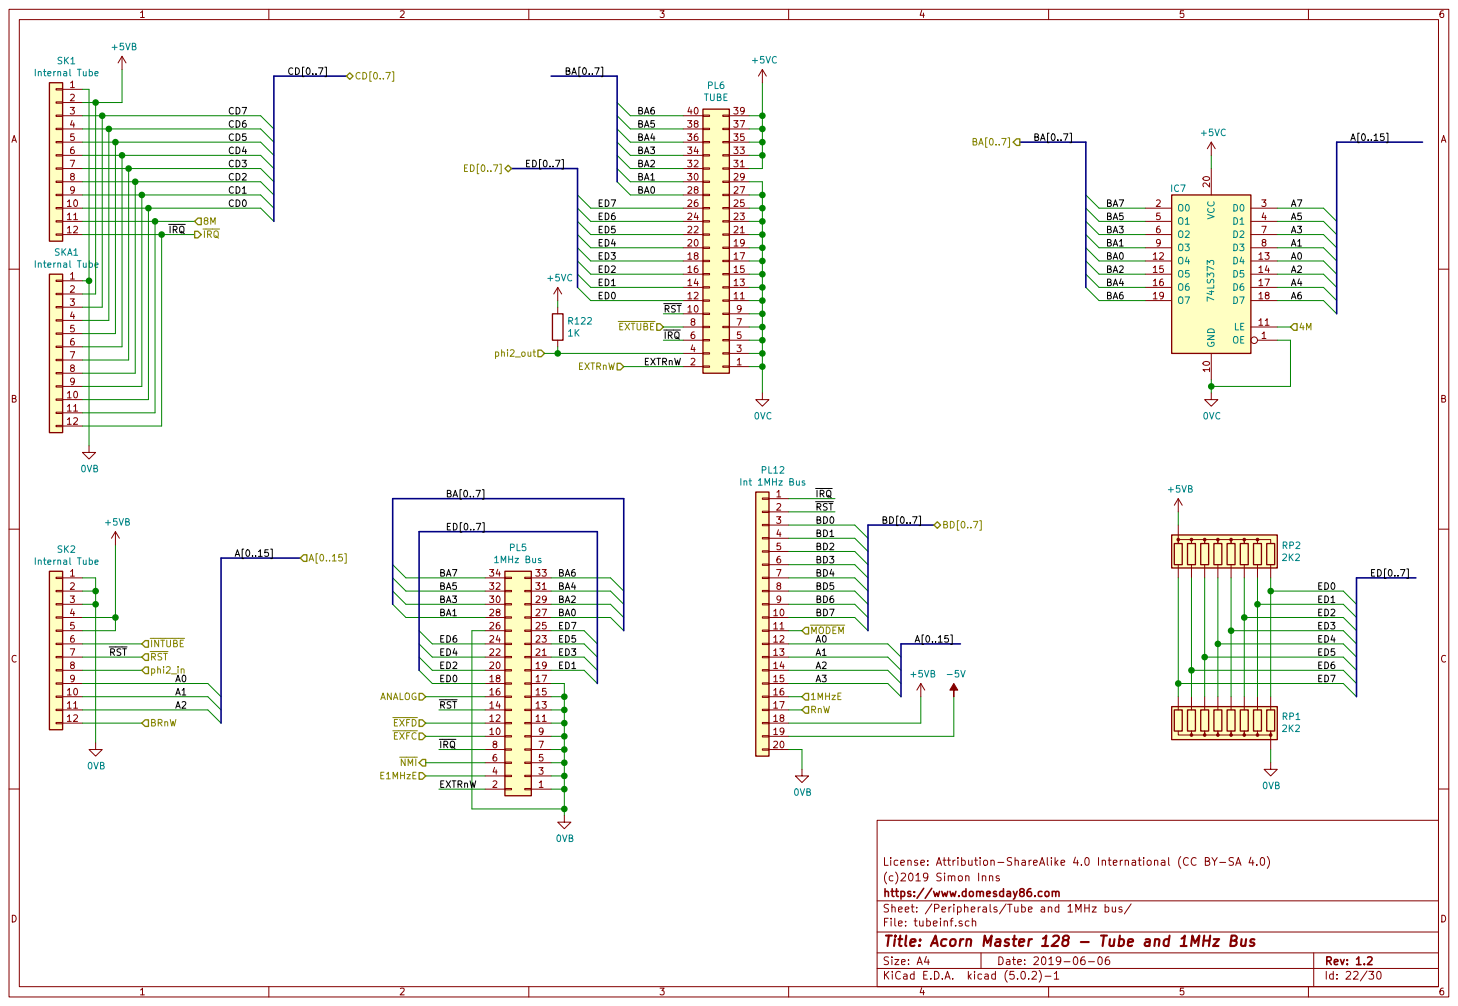
[picture p27: page 22]

License: Attribution-ShareAlike 4.0 International (CC BY-SA 4.0)
(c)2019 Simon Inns
https://www.domesday86.com
File: tubeinf.sch Sheet: /Peripherals/Tube and 1MHz bus/
Id: 22/30 Title: Acorn Master 128 - Tube and 1MHz Bus

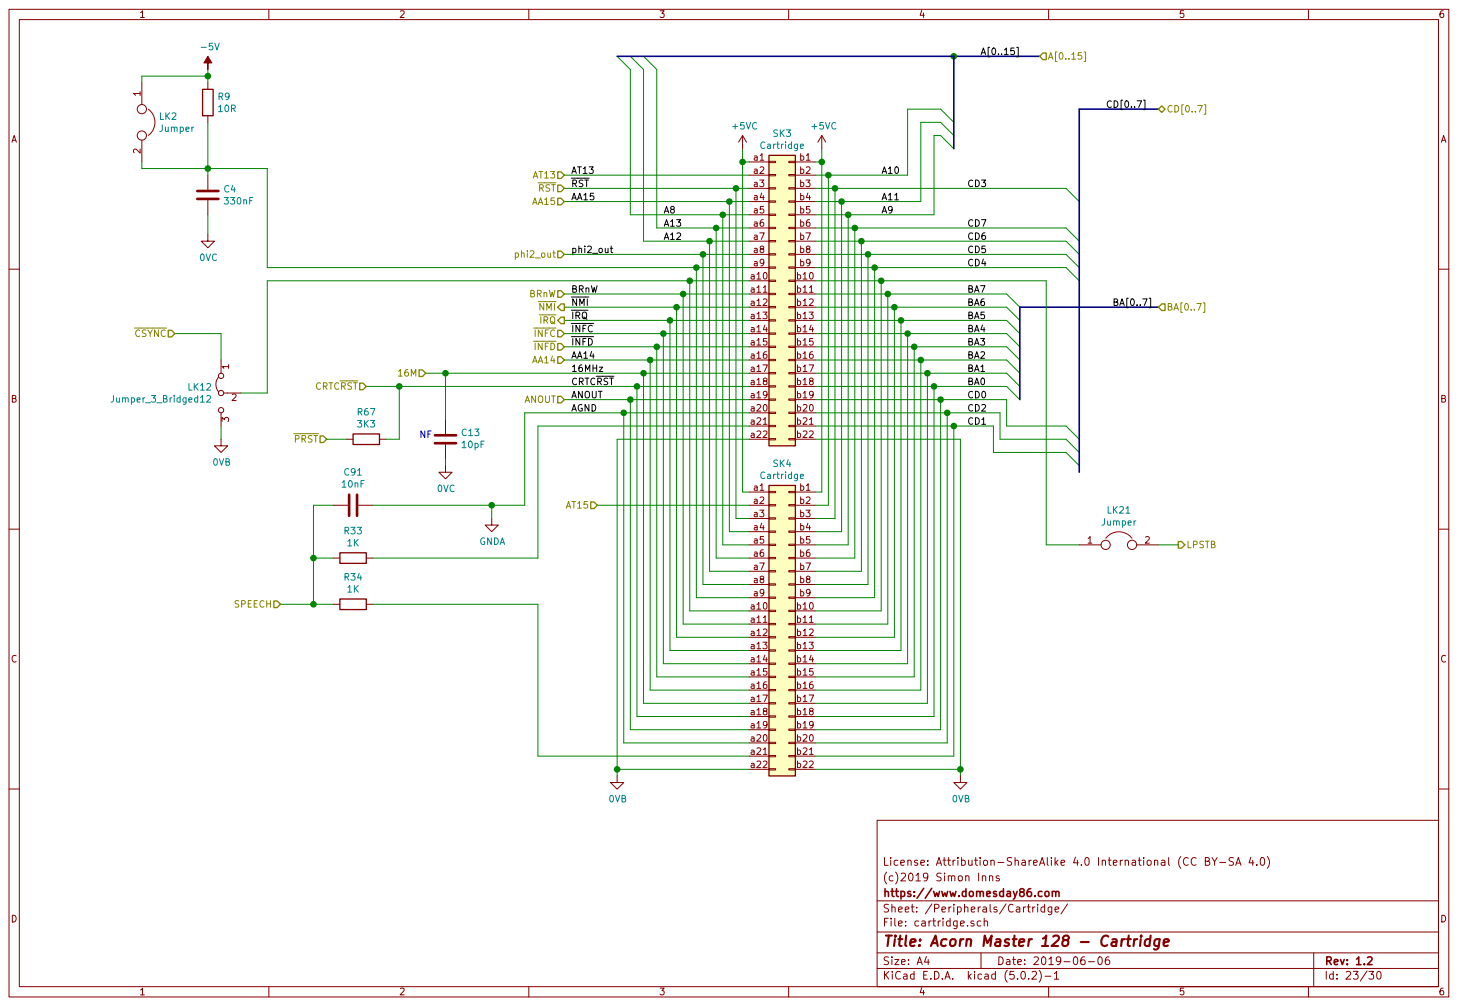
[picture p28: page 23]

a21 | | b21
a22 | | b22

License: Attribution-ShareAlike 4.0 International (CC BY-SA 4.0)
(c)2019 Simon Inns
https://www.domesday86.com
Sheet: /Peripherals/Cartridge/
File: cartridge.sch
Id: 23/30 Title: Acorn Master 128 - Cartridge

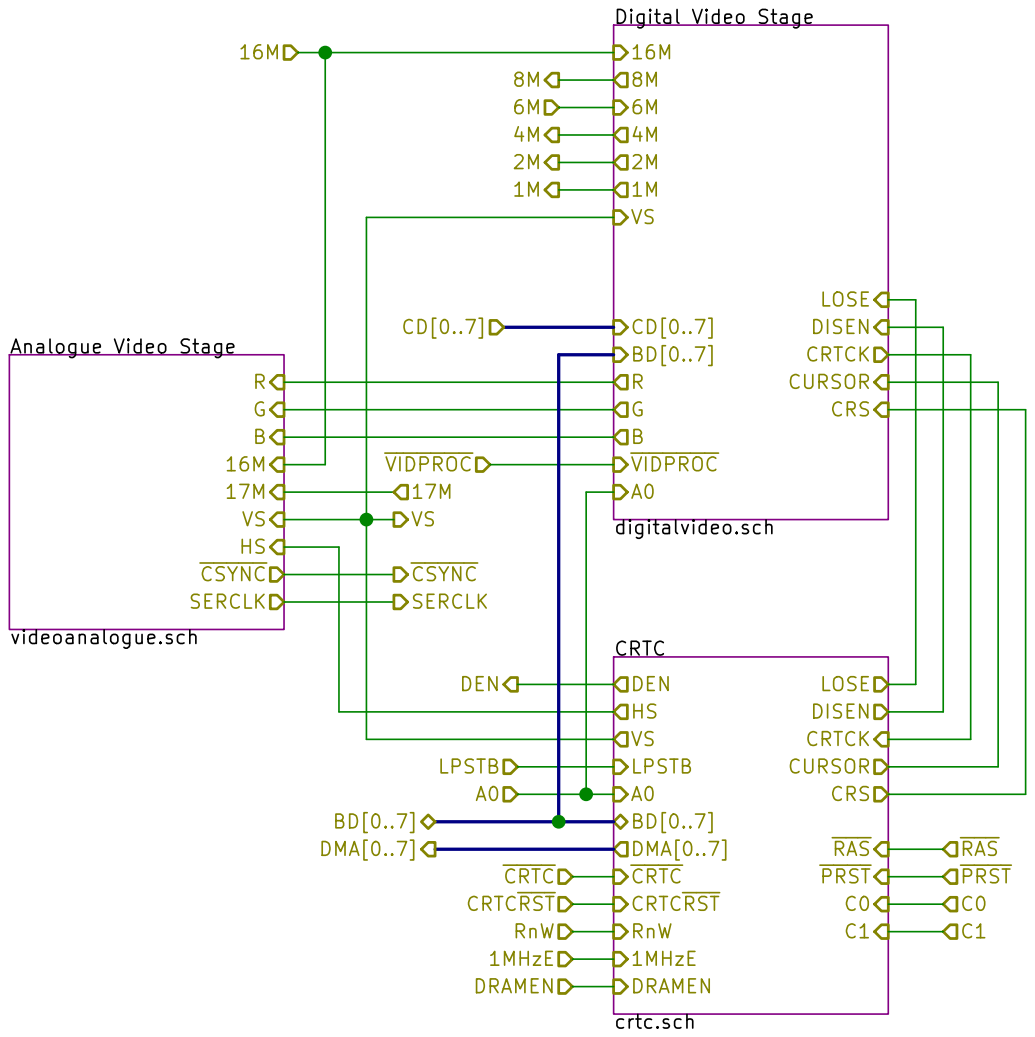
[picture p29: page 24]

LOSE CRSC0 C1 CRTCRST HS
crtc.sch BD[0..7] LPSTB

License: Attribution-ShareAlike 4.0 International (CC BY-SA 4.0)
(c)2019 Simon Inns
File: video.sch Sheet: /Video/ https://www.domesday86.com

Id: 24/30 Title: Acorn Master 128 - Video

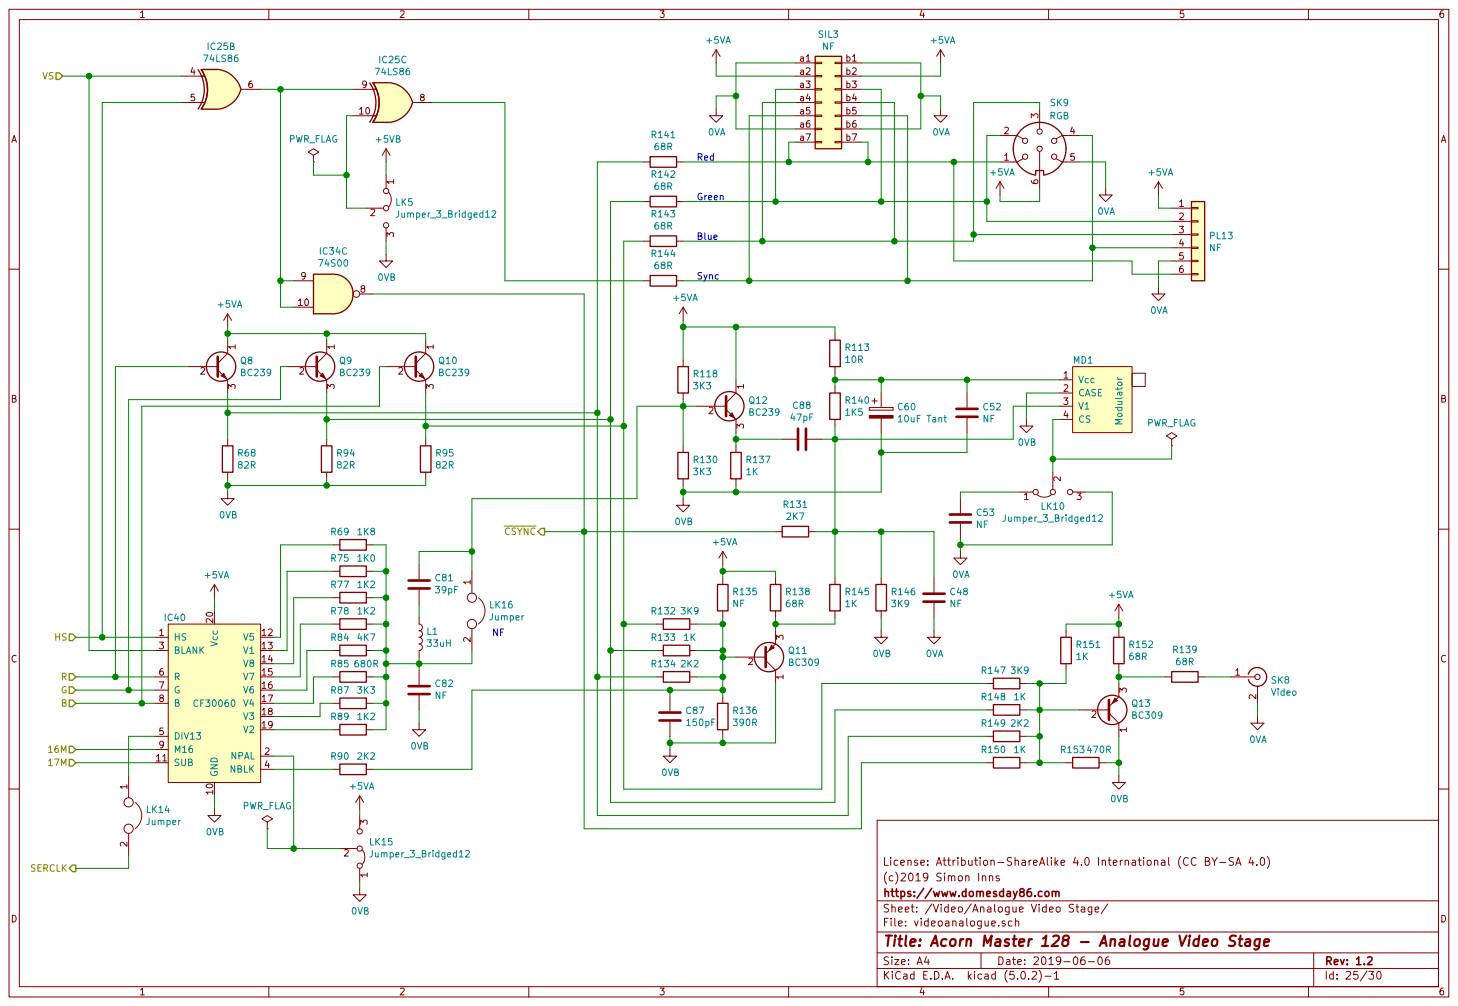
[picture p30: page 25]

a2 | | b2
a3 | | b3
a4 | | b4
a5 | | b5
a6 | | b6
a7

(c)2019 Simon Inns
https://www.domesday86.com
Sheet: /Video/Analogue Video Stage/
File: videoanalogue.sch
Id: 25/30 Title: Acorn Master 128 - Analogue Video Stage

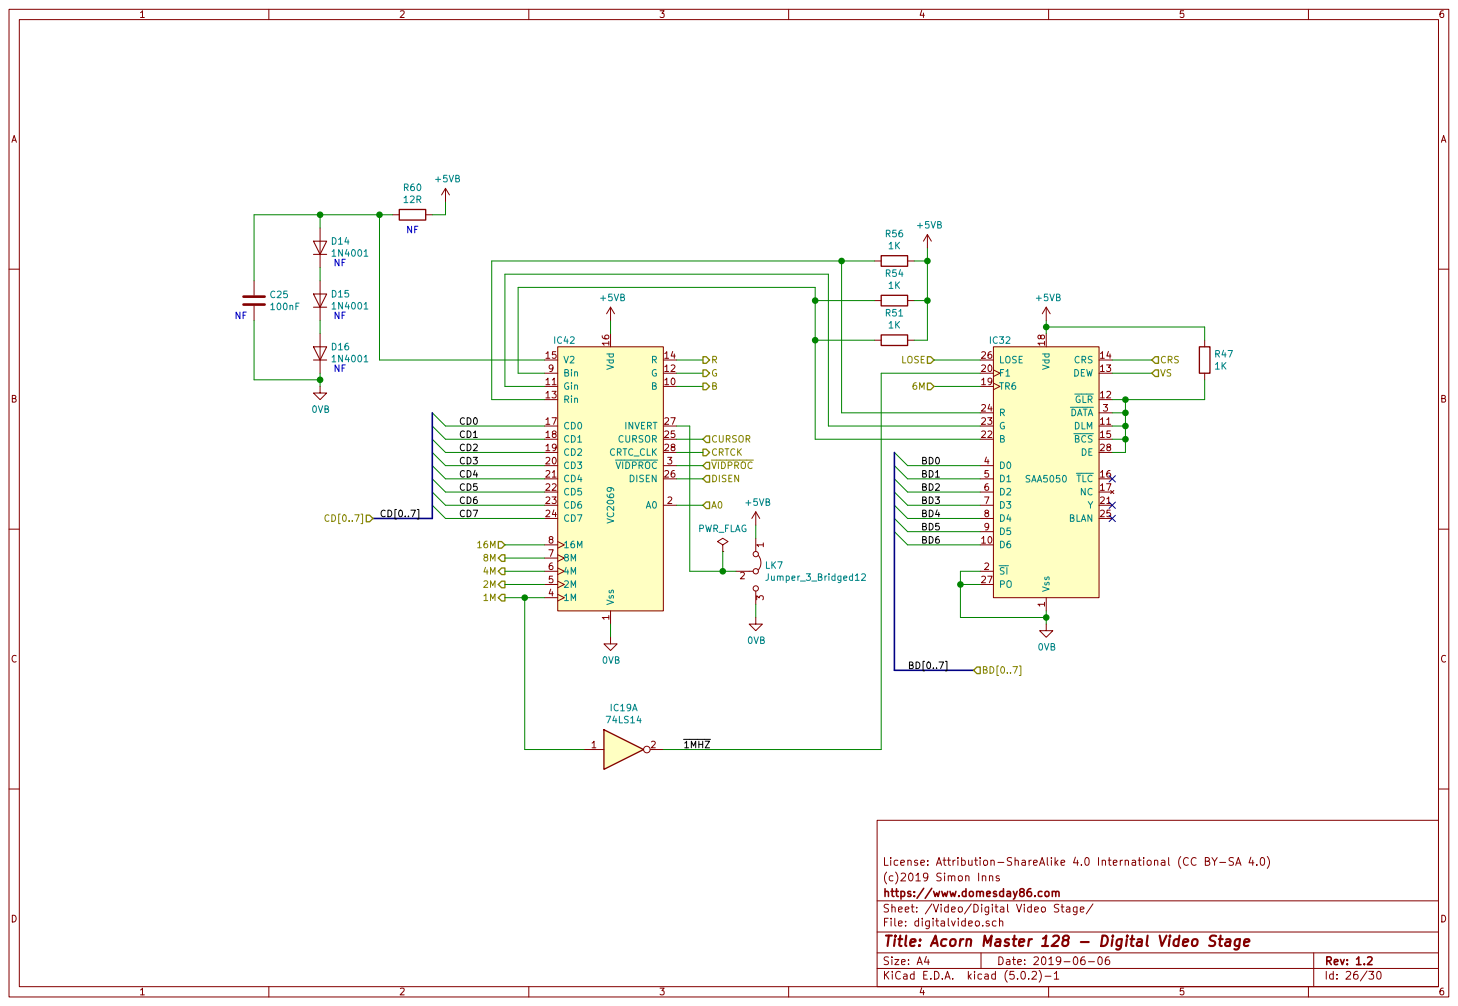
[picture p31: page 26]

(c)2019 Simon Inns
https://www.domesday86.com
Sheet: /Video/Digital Video Stage/
File: digitalvideo.sch
Id: 26/30 Title: Acorn Master 128 - Digital Video Stage

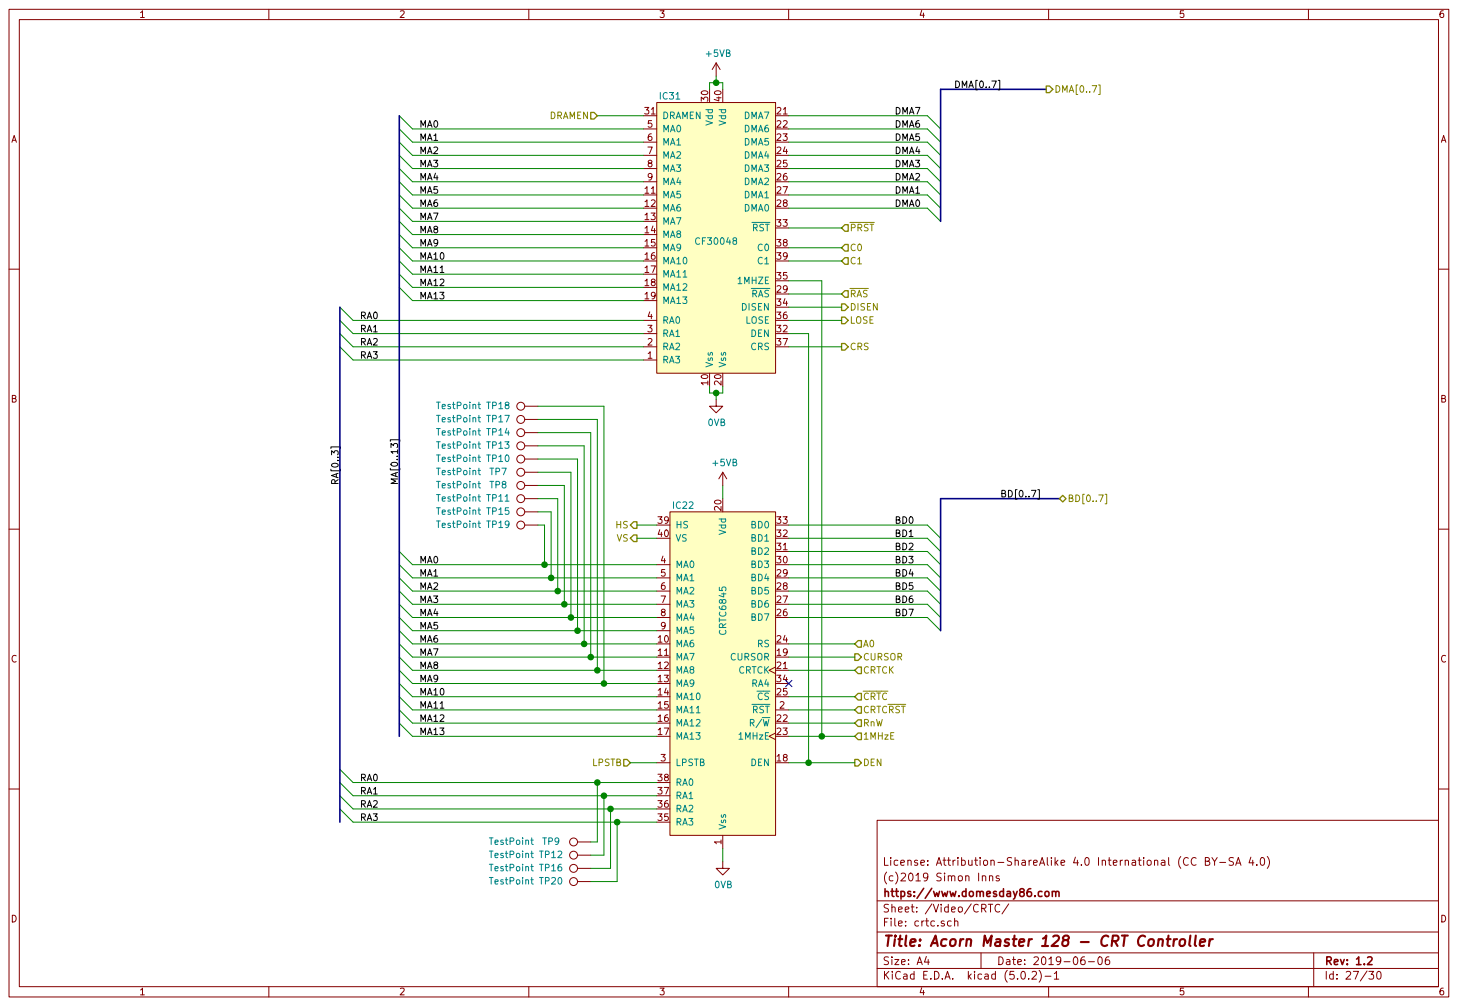
[picture p32: page 27]

(c)2019 Simon Inns
Id: 27/30 Title: Acorn Master 128 - CRT Controller File: crtc.sch Sheet: /Video/CRTC/ https://www.domesday86.com

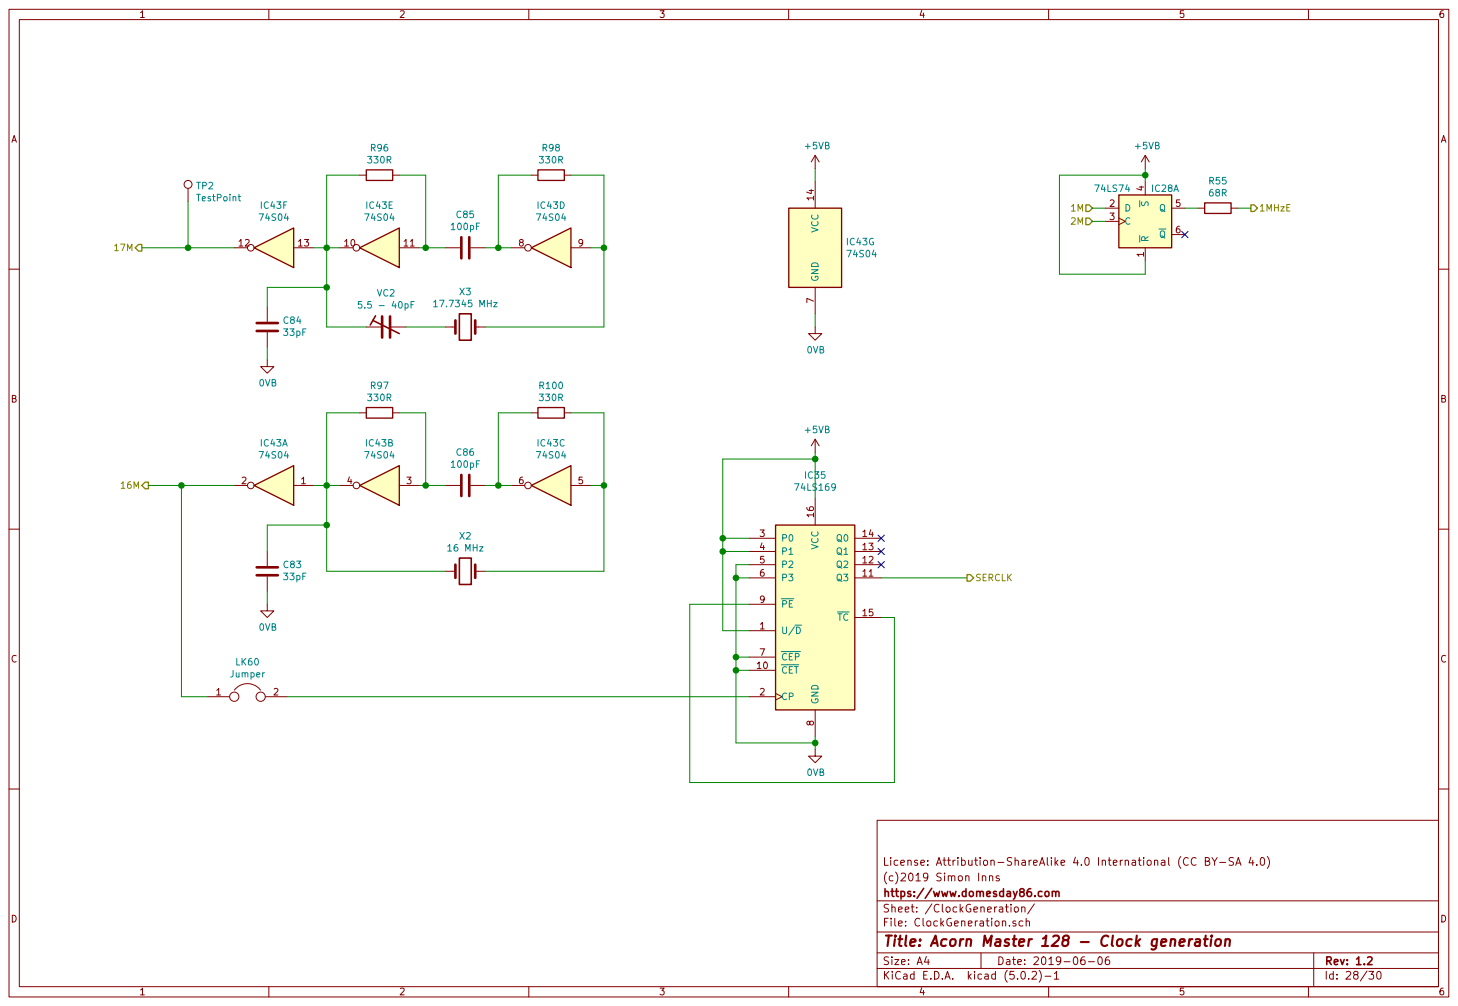
[picture p33: page 28]

License: Attribution-ShareAlike 4.0 International (CC BY-SA 4.0)
(c)2019 Simon Inns
File: ClockGeneration.sch Sheet: /ClockGeneration/ https://www.domesday86.com

Id: 28/30 Title: Acorn Master 128 - Clock generation

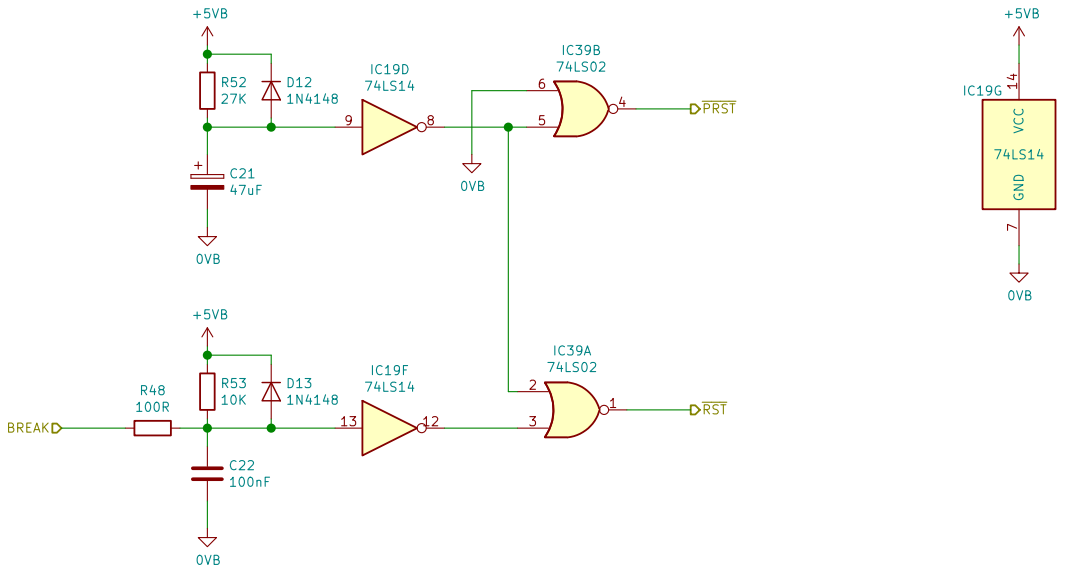
[picture p34: page 29]

License: Attribution-ShareAlike 4.0 International (CC BY-SA 4.0)
(c)2019 Simon Inns
Id: 29/30 Title: Acorn Master 128 - Reset circuit File: reset.sch Sheet: /Reset/ https://www.domesday86.com

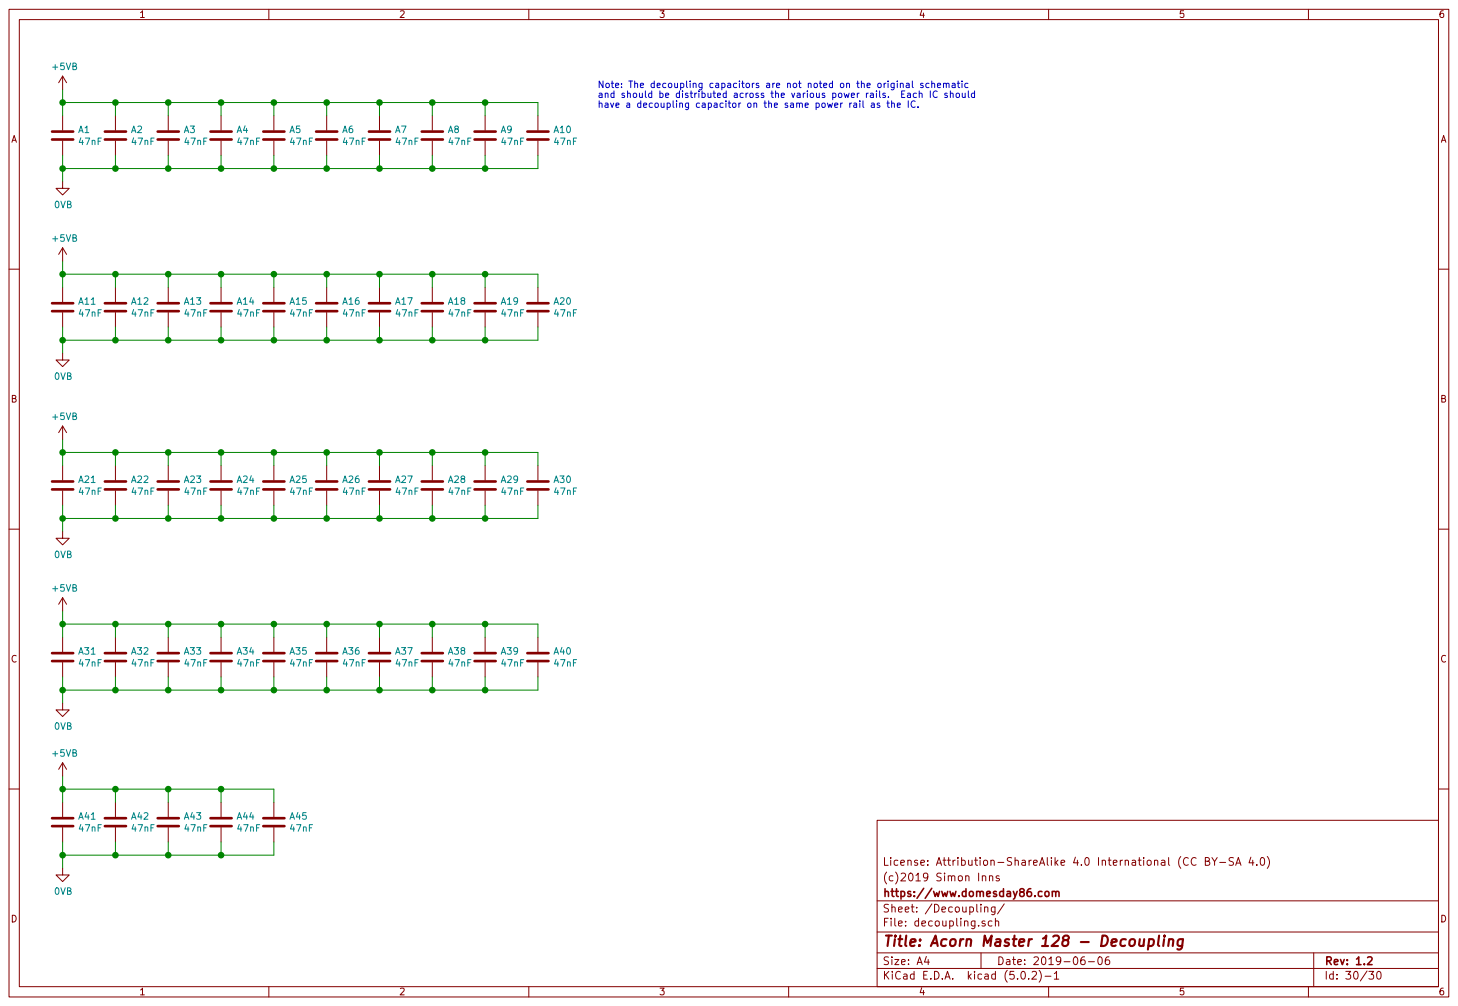
[picture p35: page 30]

Note: The decoupling capacitors are not noted on the original schematic
and should be distributed across the various power rails. Each IC should
have a decoupling capacitor on the same power rail as the IC.

License: Attribution-ShareAlike 4.0 International (CC BY-SA 4.0)
(c)2019 Simon Inns
https://www.domesday86.com
Sheet: /Decoupling/
File: decoupling.sch
Id: 30/30 Title: Acorn Master 128 - Decoupling
