simoninns/Acorn-Master-AIV/Schematics/Acorn Master 128/Acorn Master 128/ClockGeneration.sch

## KiCad design Schematics/Acorn Master 128/Acorn Master 128/ClockGeneration.sch (2019-06-06)

Schematic: ClockGeneration.sch

Parts:
C83, C84: 33pF
C85, C86: 100pF
IC28: 74LS74
IC35: 74LS169
IC43: 74S04
LK60: Jumper
R55: 68R
R96, R97, R98, R100: 330R
TP2: TestPoint
VC2: 5.5 - 40pF
X2: 16 MHz
X3: 17.7345 MHz
