simoninns/Acorn-Master-AIV/Schematics/Acorn Master 128/Acorn Master 128/adc.sch

## KiCad design Schematics/Acorn Master 128/Acorn Master 128/adc.sch (2019-06-06)

Schematic: adc.sch

Parts:
C36: 33nF
C47: 10nF
C49: 1uF Tant
C51: 33pF
C75, C76: 39pF
D17, D18, D19: 1N4148; D_DO-35_SOD27_P7.62mm_Horizontal
IC49: uPD7002
LK13: Jumper_3_Bridged12
PR1: Link
R88: 2K7
R105: 2K2
SK12: Analogue
SP3: Star
SP4: Star Ground

Notes on the sheet:
GD1/GD2 Read Datasheet
