simoninns/Acorn-Master-AIV/Schematics/Acorn Master 128/Acorn Master 128/addressmux.sch

## KiCad design Schematics/Acorn Master 128/Acorn Master 128/addressmux.sch (2019-03-31)

Schematic: addressmux.sch

Parts:
C92: 47pF
IC15: CF30050
IC19: 74LS14
R44: 220R
R107: 2K2
