simoninns/Acorn-Master-AIV/Schematics/Acorn Master 128/Acorn Master 128/audio.sch

## KiCad design Schematics/Acorn Master 128/Acorn Master 128/audio.sch (2019-06-06)

Schematic: audio.sch

Parts:
C2, C10: 100nF
C3: 100pF
C8: NF
C9, C12: 2.2nF
C14: 4.7uF Tant
C15, C17: 10uF Tant
C16: 47nF
C18: 47uF Elec
C77: 39pF
C79: 330nF
D7, D23, D24: 1N4148; D_DO-35_SOD27_P7.62mm_Horizontal
IC9: LM324
IC12: SN76489AN
IC13: LM386
LK_A1: Jumper
LK_B1: Jumper
PL9: SPKR
PL10: Modem Audio
R8, R18, R19, R20, R28, R32, R71, R120: 10K
R10, R22, R30: 100K
R13, R117: 1K
R25: NF
R26: 4K7
R27, R37, R38: 10R
R31: 39K
R35: 220K
R36: 22K
R39: 39R
R115: 47K
R116: 6K8
R119: 33K
SK13: Audio Output
