simoninns/Acorn-Master-AIV/Schematics/Acorn Master 128/Acorn Master 128/cartridge.sch

## KiCad design Schematics/Acorn Master 128/Acorn Master 128/cartridge.sch (2019-06-06)

Schematic: cartridge.sch

Parts:
C4: 330nF
C13: 10pF
C91: 10nF
LK2, LK21: Jumper
LK12: Jumper_3_Bridged12
R9: 10R
R33, R34: 1K
R67: 3K3
SK3, SK4: Cartridge
