simoninns/Acorn-Master-AIV/Schematics/Acorn Master 128/Acorn Master 128/casgeneration.sch

## KiCad design Schematics/Acorn Master 128/Acorn Master 128/casgeneration.sch (2019-06-06)

Schematic: casgeneration.sch

Parts:
C23, C24, C26: 22pF
C30: 270pF
IC19: 74LS14
IC25: 74LS86
IC28: 74LS74
IC34: 74S00
IC36: 74F00
IC38: 74LS00
IC39: 74LS02
LK18, LK19: Jumper_3_Open
R49, R50, R58: 100R
R59: 150R
R62, R64, R127: 33R
R125, R126: 4K7

Notes on the sheet:
West
