simoninns/Acorn-Master-AIV/Schematics/Acorn Master 128/Acorn Master 128/cassette.sch

## KiCad design Schematics/Acorn Master 128/Acorn Master 128/cassette.sch (2019-06-06)

Schematic: cassette.sch

Parts:
C32: 1uF Tant
C34, C46: 220nF
C35: 2.2nF
C40, C43: 4.7nF
C54: 33pF
C55, C56, C59: 820pF
D20, D21, D22: 1N4148; D_DO-35_SOD27_P7.62mm_Horizontal
IC46: LM324
Q5, Q6, Q14: BC239
R61, R83, R109, R114: 10K
R66: 3K3
R70: 270K
R72, R73: 4K7
R74: 5K6
R76: 2K2
R80: 100K
R91: 39K
R92, R101: 8K2
R104: 220K
R110, R111: 150K
R112: 820K
RL1: DIPxx-1Axx-11x; Relay_StandexMeder_DIP_LowProfile
SK11: Cassette

Notes on the sheet:
Verify relay type!
