simoninns/Acorn-Master-AIV/Schematics/Acorn Master 128/Acorn Master 128/cpu.sch

## KiCad design Schematics/Acorn Master 128/Acorn Master 128/cpu.sch (2019-06-06)

Schematic: cpu.sch

Parts:
C19: 10pF
IC14: 65SC12
R43: 1K
TP3, TP4, TP5, TP6: TestPoint
