simoninns/Acorn-Master-AIV/Schematics/Acorn Master 128/Acorn Master 128/crtc.sch

## KiCad design Schematics/Acorn Master 128/Acorn Master 128/crtc.sch (2019-06-06)

Schematic: crtc.sch

Parts:
IC22: CRTC6845
IC31: CF30048
TP7, TP8, TP9, TP10, TP11, TP12, TP13, TP14, TP15, TP16, TP17, TP18, TP19, TP20: TestPoint
