simoninns/Acorn-Master-AIV/Schematics/Acorn Master 128/Acorn Master 128/databusmux.sch

## KiCad design Schematics/Acorn Master 128/Acorn Master 128/databusmux.sch (2019-03-31)

Schematic: databusmux.sch

Parts:
C20: 10uF Tant
D11: 1N4148; D_DO-35_SOD27_P7.62mm_Horizontal
IC19: 74LS14
IC21: CF30049
R45: 10K
R46: 1M
