simoninns/Acorn-Master-AIV/Schematics/Acorn Master 128/Acorn Master 128/decoupling.sch

## KiCad design Schematics/Acorn Master 128/Acorn Master 128/decoupling.sch (2019-06-06)

Schematic: decoupling.sch

Parts:
A1, A2, A3, A4, A5, A6, A7, A8, A9, A10, A11, A12, A13, A14, A15, A16, A17, A18, A19, A20, A21, A22, A23, A24, A25, A26, A27, A28, A29, A30, A31, A32, A33, A34, A35, A36, A37, A38, A39, A40, A41, A42, A43, A44, A45: 47nF

Notes on the sheet:
Note: The decoupling capacitors are not noted on the original schematic and should be distributed across the various power rails. Each IC should have a decoupling capacitor on the same power rail as the IC.
