simoninns/Acorn-Master-AIV/Schematics/Acorn Master 128/Acorn Master 128/digitalvideo.sch

## KiCad design Schematics/Acorn Master 128/Acorn Master 128/digitalvideo.sch (2019-06-06)

Schematic: digitalvideo.sch

Parts:
C25: 100nF
D14, D15, D16: 1N4001; D_DO-41_SOD81_P10.16mm_Horizontal
IC19: 74LS14
IC32: SAA5050
IC42: VC2069
LK7: Jumper_3_Bridged12
R47, R51, R54, R56: 1K
R60: 12R
