simoninns/Acorn-Master-AIV/Schematics/Acorn Master 128/Acorn Master 128/econetinf.sch

## KiCad design Schematics/Acorn Master 128/Acorn Master 128/econetinf.sch (2019-06-06)

Schematic: econetinf.sch

Parts:
SIL2: NF
SK5, SK6: Econet Module
SK7: ECONET
