simoninns/Acorn-Master-AIV/Schematics/Acorn Master 128/Acorn Master 128/fdcinterface.sch

## KiCad design Schematics/Acorn Master 128/Acorn Master 128/fdcinterface.sch (2019-06-06)

Schematic: fdcinterface.sch

Parts:
C1: 33/47nF
C27: 200pF
D1, D2, D3: 1N4148; D_DO-35_SOD27_P7.62mm_Horizontal
IC1: 7406
IC2: 7438
IC3: WD1772
IC4: 74LS174
IC19: 74LS14
PL1: Disc Ext.
PL2: Disc Int. (NF)
Q1: BC239
R1, R3, R5, R6: 150R
R2: 1K
