simoninns/Acorn-Master-AIV/Schematics/Acorn Master 128/Acorn Master 128/iocontroller.sch

## KiCad design Schematics/Acorn Master 128/Acorn Master 128/iocontroller.sch (2019-06-06)

Schematic: iocontroller.sch

Parts:
C92: 47pF
IC15: CF30050
R44: 220R
R107: 2K2
