simoninns/Acorn-Master-AIV/Schematics/Acorn Master 128/Acorn Master 128/memorycontroller.sch

## KiCad design Schematics/Acorn Master 128/Acorn Master 128/memorycontroller.sch (2019-06-06)

Schematic: memorycontroller.sch

Parts:
C78: 27pF
IC20: CF30058
R65: 1K5
