simoninns/Acorn-Master-AIV/Schematics/Acorn Master 128/Acorn Master 128/ram.sch

## KiCad design Schematics/Acorn Master 128/Acorn Master 128/ram.sch (2019-06-06)

Schematic: ram.sch

Parts:
IC17, IC18, IC23, IC26: HM50464-12
