simoninns/Acorn-Master-AIV/Schematics/Acorn Master 128/Acorn Master 128/ramaddr.sch

## KiCad design Schematics/Acorn Master 128/Acorn Master 128/ramaddr.sch (2019-06-06)

Schematic: ramaddr.sch

Parts:
IC29, IC33: 74HCT253
IC30: 74LS257
