simoninns/Acorn-Master-AIV/Schematics/Acorn Master 128/Acorn Master 128/reset.sch

## KiCad design Schematics/Acorn Master 128/Acorn Master 128/reset.sch (2019-06-06)

Schematic: reset.sch

Parts:
C21: 47uF
C22: 100nF
D12, D13: 1N4148; D_DO-35_SOD27_P7.62mm_Horizontal
IC19: 74LS14
IC39: 74LS02
R48: 100R
R52: 27K
R53: 10K
