simoninns/Acorn-Master-AIV/Schematics/Acorn Master 128/Acorn Master 128/roms.sch

## KiCad design Schematics/Acorn Master 128/Acorn Master 128/roms.sch (2019-06-06)

Schematic: roms.sch

Parts:
IC24: MOS
IC27, IC37, IC41: 27C256; DIP-28_W15.24mm
LK9: Jumper_3_Bridged12
R128, R129: 4K7
