simoninns/Acorn-Master-AIV/Schematics/Acorn Master 128/Acorn Master 128/rtccmos.sch

## KiCad design Schematics/Acorn Master 128/Acorn Master 128/rtccmos.sch (2019-06-06)

Schematic: rtccmos.sch

Parts:
C6, C7: 33pF
C11: 10uF Tant
D5, D6, D8: 1N4148; D_DO-35_SOD27_P7.62mm_Horizontal
IC11: MC146818P
LK4: Jumper
PL8: Battery
Q2: BC213
Q3: BC239
Q4: J177
R12: 1K
R15: 560R
R16: 8R2
R17: 5M6
R23, R29: 10K
R24: 100K
R154: 470R
R155: 1M
TP1: TestPoint
VC1: 2-22pF
X1: 32.768 KHz
