simoninns/Acorn-Master-AIV/Schematics/Acorn Master 128/Acorn Master 128/serial.sch

## KiCad design Schematics/Acorn Master 128/Acorn Master 128/serial.sch (2019-06-06)

Schematic: serial.sch

Parts:
C39: 47uF Tant
C44, C45: 47pF
IC45: MC6850
IC48: VC2026
IC50: AM26LS30
IC51: uA9637AC
R82: 56K
R102: 10K
R103: 2K7
SIL4: NF
SK10: RS423 Conn
