simoninns/Acorn-Master-AIV/Schematics/Acorn Master 128/Acorn Master 128/supply.sch

## KiCad design Schematics/Acorn Master 128/Acorn Master 128/supply.sch (2019-06-06)

Schematic: supply.sch

Parts:
C61, C62, C63, C64, C65, C66, C67, C68, C69: 270pF
C70, C71, C72, C73: 47uF Elec
L2, L3, L4, L5, L6, L7, L8, L9, L10: 6u8 WL
PL14: Not Fitted
PL15, PL16, PL17, PL18, PL19, PL20, PL21, PL22, PL23: Conn_01x01

Notes on the sheet:
Chassis Ground
