simoninns/Acorn-Master-AIV/Schematics/Acorn Master 128/Acorn Master 128/tubeinf.sch

## KiCad design Schematics/Acorn Master 128/Acorn Master 128/tubeinf.sch (2019-06-06)

Schematic: tubeinf.sch

Parts:
IC7: 74LS373
PL5: 1MHz Bus
PL6: TUBE
PL12: Int 1MHz Bus
R122: 1K
RP1, RP2: 2K2; R_Array_SIP9
SK1, SK2: Internal Tube
SKA1: Internal Tube
