simoninns/Acorn-Master-AIV/Schematics/Acorn Master 128/Acorn Master 128/viaa.sch

## KiCad design Schematics/Acorn Master 128/Acorn Master 128/viaa.sch (2019-06-06)

Schematic: viaa.sch

Parts:
C5: 33pF NF
D9, D10: 1N4148; D_DO-35_SOD27_P7.62mm_Horizontal
IC8: R6522
IC10: 74LS259
IC16: CF30047
PL7: Keyboard Con. 2
PL11: Keyboard 1
PL24: Keyboard 2
R14, R21: 10K
R40, R41, R42: 330R
R57: 100R
SIL1: NF

Notes on the sheet:
Power LED
Caps Lock LED
Shift Lock LED
