simoninns/Acorn-Master-AIV/Schematics/Acorn Master 128/Acorn Master 128/viab.sch

## KiCad design Schematics/Acorn Master 128/Acorn Master 128/viab.sch (2019-06-06)

Schematic: viab.sch

Parts:
IC2: 7438
IC5: 74LS244
IC6: R6522
PL3: Printer
PL4: User Port
R4, R11: 2K2
R7: 4K7
