simoninns/Acorn-Master-AIV/Schematics/Acorn Master 128/Acorn Master 128/videoanalogue.sch

## KiCad design Schematics/Acorn Master 128/Acorn Master 128/videoanalogue.sch (2019-06-06)

Schematic: videoanalogue.sch

Parts:
C48, C52, C53, C82: NF
C60: 10uF Tant
C81: 39pF
C87: 150pF
C88: 47pF
IC25: 74LS86
IC34: 74S00
IC40: CF30060
L1: 33uH
LK5, LK10, LK15: Jumper_3_Bridged12
LK14, LK16: Jumper
MD1: Modulator
PL13: NF
Q8, Q9, Q10, Q12: BC239
Q11, Q13: BC309
R68, R94, R95: 82R
R69: 1K8
R75: 1K0
R77, R78, R89: 1K2
R84: 4K7
R85: 680R
R87, R118, R130: 3K3
R90, R134, R149: 2K2
R113: 10R
R131: 2K7
R132, R146, R147: 3K9
R133, R137, R145, R148, R150, R151: 1K
R135: NF
R136: 390R
R138, R139, R141, R142, R143, R144, R152: 68R
R140: 1K5
R153: 470R
SIL3: NF
SK8: Video
SK9: RGB

Notes on the sheet:
Red
Green
Blue
Sync
