simoninns/Acorn-Master-AIV/Schematics/Acorn Master 128/Acorn Master Keyboard/Acorn Master Keyboard.sch

## KiCad design Schematics/Acorn Master 128/Acorn Master Keyboard/Acorn Master Keyboard.sch (2019-03-31)

Schematic: Acorn Master Keyboard.sch

Parts:
BT1: Battery
D1, D2, D3: LED
J1: Keyboard 1
J2: Keyboard 2
SW1: ESCAPE
SW2: TAB
SW3: SHIFT Lk
SW4: CAPS Lk
SW5: ! 1
SW6: f0
SW7: Q
SW8, SW16: SHIFT
SW9: f1
SW10: Z
SW11: S
SW12: A
SW13: \" 2
SW14: W
SW15: # 3
SW17: CTRL
SW18: f2
SW19: SPACE
SW20: C
SW21: X
SW22: D
SW23: E
SW24: $ 4
SW25: f3
SW26: V
SW27: G
SW28: F
SW29: R
SW30: T
SW31: % 5
SW32: f5
SW33: B
SW34: H
SW35: Y
SW36: & 6
SW37: ' 7
SW38: f4
SW39: f6
SW40: M
SW41: N
SW42: J
SW43: U
SW44: I
SW45: ( 8
SW46: BREAK
SW47: f8
SW48: <
SW49: L
SW50: K
SW51: O
SW52: ) 9
SW53: f7
SW54: f9
SW55: > ,
SW56: + ;
SW57: @
SW58: P
SW59: 0
SW60: = -
SW61: | \\
SW62: ? /
SW63: } ]
SW64: * :
SW65: { [
SW66: £ _
SW67: ~~ ^
SW68: Left
SW69: COPY
SW70: DELETE
SW71: RETURN
SW72: UP
SW73: DOWN
SW74: RIGHT
SW75: 4 (NKP)
SW76: 0 (NKP)
SW77: # (NKP)
SW78: / (NKP)
SW79: + (NKP)
SW80: 8 (NKP)
SW81: 6 (NKP)
SW82: 5 (NKP)
SW83: 1 (NKP)
SW84: * (NKP)
SW85: DEL (NKP)
SW86: - (NKP)
SW87: 9 (NKP)
SW88: 7 (NKP)
SW89: 2 (NKP)
SW90: 3 (NKP)
SW91: Comma (NKP)
SW92: . (NKP)
SW93: RETURN (NKP)

Notes on the sheet:
POWER ON
CAPS LOCK
SHIFT LOCK
Note: NPK = Numeric Key Pad
