simoninns/Acorn-Master-AIV/(commit log)

2019-03-27 Partial schematics included and data sheets
    [Acorn Master 128.kicad_pcb, Acorn Master 128.sch, ClockGeneration.sch, cpu.sch, memory.sch, ram.sch, ramaddr.sch, reset.sch]
2019-03-27 More memory logic schematics
    [Acorn Master 128.sch, ClockGeneration.sch, casgeneration.sch, cpu.sch, memory.sch, ram.sch, ramaddr.sch, reset.sch]
2019-03-27 Video IC foot-prints added
    [Acorn Master 128.sch, ClockGeneration.sch, casgeneration.sch, cpu.sch, memory.sch, ram.sch, ramaddr.sch, reset.sch]
2019-03-27 Added 6845 foot-print and databus mux schematic
    [Acorn Master 128.sch, ClockGeneration.sch, casgeneration.sch, cpu.sch, databusmux.sch, memory.sch, ram.sch, ramaddr.sch]
2019-03-27 Added address multiplexer
    [Acorn Master 128.sch, ClockGeneration.sch, addressmux.sch, casgeneration.sch, cpu.sch, databusmux.sch, memory.sch, ram.sch]
2019-03-27 Added analogue video stage
    [Acorn Master 128.sch, ClockGeneration.sch, addressmux.sch, casgeneration.sch, cpu.sch, databusmux.sch, memory.sch, ram.sch]
2019-03-27 Added digital video stage
    [Acorn Master 128.sch, ClockGeneration.sch, addressmux.sch, casgeneration.sch, cpu.sch, databusmux.sch, digitalvideo.sch, memory.sch]
2019-03-28 Added CRTC controller
    [Acorn Master 128.sch, ClockGeneration.sch, addressmux.sch, casgeneration.sch, cpu.sch, crtc.sch, databusmux.sch, digitalvideo.sch]
2019-03-28 Added memory controller IC
    [Acorn Master 128.sch, ClockGeneration.sch, addressmux.sch, casgeneration.sch, cpu.sch, crtc.sch, databusmux.sch, digitalvideo.sch]
2019-03-28 Added cartridge connectors
    [Acorn Master 128.sch, ClockGeneration.sch, addressmux.sch, cartridge.sch, casgeneration.sch, cpu.sch, crtc.sch, databusmux.sch]
2019-03-28 Added Tube and 1MHz bus interfaces (internal and external)
    [Acorn Master 128.sch, ClockGeneration.sch, addressmux.sch, cartridge.sch, casgeneration.sch, cpu.sch, crtc.sch, databusmux.sch]
2019-03-28 Added Econet module interface
    [Acorn Master 128.sch, ClockGeneration.sch, addressmux.sch, cartridge.sch, casgeneration.sch, cpu.sch, crtc.sch, databusmux.sch]
2019-03-28 Added VIAB (User and printer ports)
    [Acorn Master 128.sch, ClockGeneration.sch, addressmux.sch, cartridge.sch, casgeneration.sch, cpu.sch, crtc.sch, databusmux.sch]
2019-03-28 Added floppy disc controller interface
    [Acorn Master 128.sch, ClockGeneration.sch, addressmux.sch, cartridge.sch, casgeneration.sch, cpu.sch, crtc.sch, databusmux.sch]
2019-03-28 Added VIA A and keyboard controller IC
    [Acorn Master 128.sch, ClockGeneration.sch, addressmux.sch, cartridge.sch, casgeneration.sch, cpu.sch, crtc.sch, databusmux.sch]
2019-03-29 Added RTC interface
    [Acorn Master 128.sch, ClockGeneration.sch, addressmux.sch, cartridge.sch, casgeneration.sch, cpu.sch, crtc.sch, databusmux.sch]
2019-03-29 Added audio interface
    [Acorn Master 128.sch, ClockGeneration.sch, addressmux.sch, audio.sch, cartridge.sch, casgeneration.sch, cpu.sch, crtc.sch]
2019-03-29 Added ADC interface
    [Acorn Master 128.sch, ClockGeneration.sch, adc.sch, addressmux.sch, audio.sch, cartridge.sch, casgeneration.sch, cpu.sch]
2019-03-29 Added serial and cassette interfaces
    [Acorn Master 128.sch, ClockGeneration.sch, adc.sch, addressmux.sch, audio.sch, cartridge.sch, casgeneration.sch, cassette.sch]
2019-03-29 Added power distribution supply
    [Acorn Master 128.sch, ClockGeneration.sch, adc.sch, addressmux.sch, audio.sch, cartridge.sch, casgeneration.sch, cassette.sch]
2019-03-29 Updated power distribution
    [Acorn Master 128.sch, ClockGeneration.sch, adc.sch, addressmux.sch, audio.sch, cartridge.sch, casgeneration.sch, cassette.sch]
2019-03-30 Additional memory and video details
    [Acorn Master 128.sch, casgeneration.sch, crtc.sch, digitalvideo.sch, memory.sch, memorycontroller.sch, ram.sch, ramaddr.sch]
2019-03-30 Corrections to video and reorganisation
    [Acorn Master 128.sch, ClockGeneration.sch, adc.sch, addressmux.sch, audio.sch, cartridge.sch, casgeneration.sch, cassette.sch]
2019-03-30 Connecting primary sheet signals
    [Acorn Master 128.sch, ClockGeneration.sch, addressmux.sch, audio.sch, casgeneration.sch, cpu.sch, databusmux.sch, memory.sch]
2019-03-30 Further routing and added sheet names
    [Acorn Master 128.sch, ClockGeneration.sch, adc.sch, addressmux.sch, audio.sch, cartridge.sch, casgeneration.sch, cassette.sch]
2019-03-30 Correction to CRTC reset signals
    [Acorn Master 128.sch, cartridge.sch, crtc.sch, video.sch]
2019-03-31 Added peripheral annotation
    [Acorn Master 128.sch, adc.sch, audio.sch, cartridge.sch, cassette.sch, econetinf.sch, fdcinterface.sch, rtccmos.sch]
2019-03-31 Corrected pin 16 of IC11 (missing from original schematic)
    [rtccmos.sch]
2019-03-31 Added missing component annotations
    [ClockGeneration.sch, adc.sch, addressmux.sch, audio.sch, cartridge.sch, casgeneration.sch, cassette.sch, cpu.sch]
2019-03-31 Corrected SIL3 in analogue video stage
    [videoanalogue.sch]
2019-03-31 Corrections to get ERC to run
    [adc.sch, audio.sch, crtc.sch, fdcinterface.sch, reset.sch, tubeinf.sch, viaa.sch, videoanalogue.sch]
2019-03-31 Corrected to pass KiCAD ERC successfully
    [Acorn Master 128.sch, adc.sch, audio.sch, cpu.sch, crtc.sch, digitalvideo.sch, fdcinterface.sch, memory.sch]
2019-03-31 Added decoupling capacitors
    [Acorn Master 128.sch, ClockGeneration.sch, adc.sch, addressmux.sch, audio.sch, cartridge.sch, casgeneration.sch, cassette.sch]
2019-03-31 Added PDF schematic
2019-03-31 Initial commit of Acorn Master Keyboard schematic
    [Acorn Master Keyboard.kicad_pcb, Acorn Master Keyboard.sch]
2019-03-31 Corrected directory location of keyboard schematic
    [Acorn Master Keyboard.kicad_pcb, Acorn Master Keyboard.sch]
2019-03-31 Initial commit of 65C102 2nd processor (basic CPU and Tube ULA footprints)
    [Acorn 65C102 Second Processor.kicad_pcb, Acorn 65C102 Second Processor.sch, tubeinterface.sch]
2019-04-02 Unverified first reverse engineering of 65C102 second processor
    [Acorn 65C102 Second Processor.sch, tubeinterface.sch]
2019-04-02 Corrections to 65C102 after physical continuity testing
    [Acorn 65C102 Second Processor.sch]
2019-04-02 Completed 65C102 second processor schematic
    [Acorn 65C102 Second Processor.sch, logic.sch, ram.sch, rom.sch, supply.sch]
2019-04-02 Added PDF of 65C102 schematic
2019-04-03 Added missing CD[0..7] databus connection to memory sheet
    [Acorn Master 128.sch, adc.sch, fdcinterface.sch, memory.sch, peripherals.sch, viaa.sch]
2019-04-03 Correction to cartridge address bus BA[0..7]
    [Acorn Master 128.sch, cartridge.sch, peripherals.sch, tubeinf.sch]
2019-04-04 Updates to naming to bring the schematic in-line with terms used by the Acorn documentation
    [Acorn Master 128.sch, iocontroller.sch, pbc.sch]
2019-04-13 Corrections to bus directions
    [Acorn Master 128.sch, crtc.sch, digitalvideo.sch, memory.sch, video.sch]
2019-04-13 Modified 8BUFF and n1MHz signal to better represent functionality
    [Acorn Master 128.sch, digitalvideo.sch, fdcinterface.sch, iocontroller.sch, peripherals.sch, video.sch]
2019-04-13 Correction to nFIT signal directions
    [Acorn Master 128.sch, iocontroller.sch, pbc.sch]
2019-04-13 Minor correction to nFIT and date update on all sheets
    [Acorn Master 128.sch, ClockGeneration.sch, adc.sch, audio.sch, cartridge.sch, casgeneration.sch, cassette.sch, cpu.sch]
2019-04-14 Corrections to ANOUT and nEOC signal routing
    [Acorn Master 128.sch, audio.sch, peripherals.sch]
2019-04-15 Corrected nEOC direction on VIAA
    [peripherals.sch, viaa.sch]
2019-04-15 Update to keyboard encoder IC according to details in the WE Advanced Master reference
    [viaa.sch]
2019-04-15 Reorganised VIAA, RTC and sound for better functional grouping
    [Acorn Master 128.sch, ClockGeneration.sch, adc.sch, audio.sch, cartridge.sch, casgeneration.sch, cassette.sch, cpu.sch]
2019-06-06 Fix for issue #1
    [Acorn Master 128.sch, ClockGeneration.sch, adc.sch, audio.sch, cartridge.sch, casgeneration.sch, cassette.sch, cpu.sch]
